drachosaurus/hoerbaer/Hardware/Messungen/Verschiedene_Spannungen_Codec.md

# Codec Temperatur und Strom bei verschiedenen Spannungen

## VAudio = 12V

Bei 384kHz
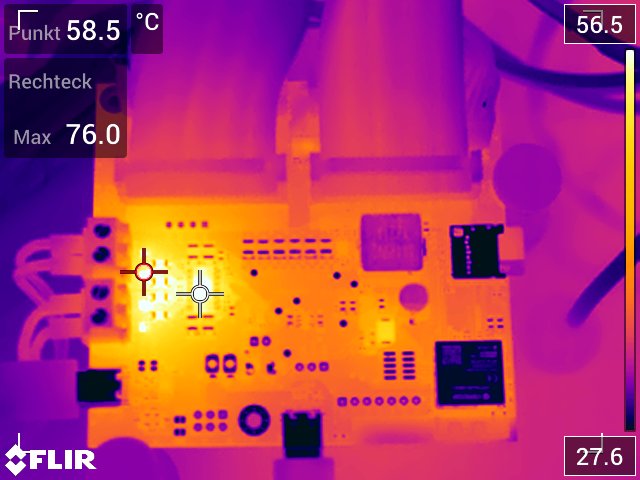
[picture p1: Hardware/Messungen/91_384kHz_12V.jpg]


Bei 768kHz
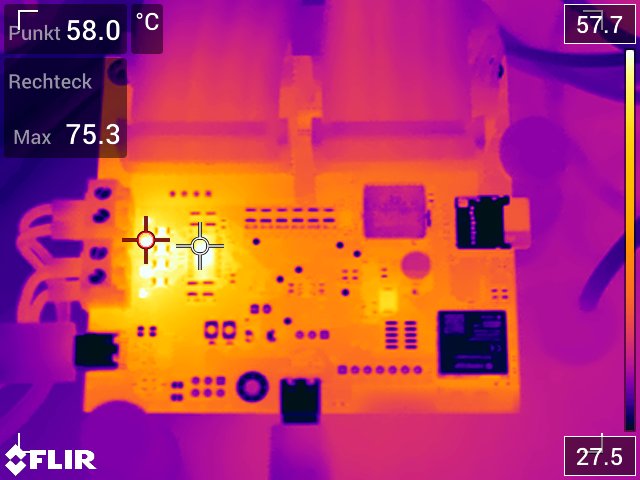
[picture p2: Hardware/Messungen/92_768kHz_12V.jpg]


### Stromaufnahme Codec
183 mA @12V = 2.2W

## VAudio = 9V

Leise
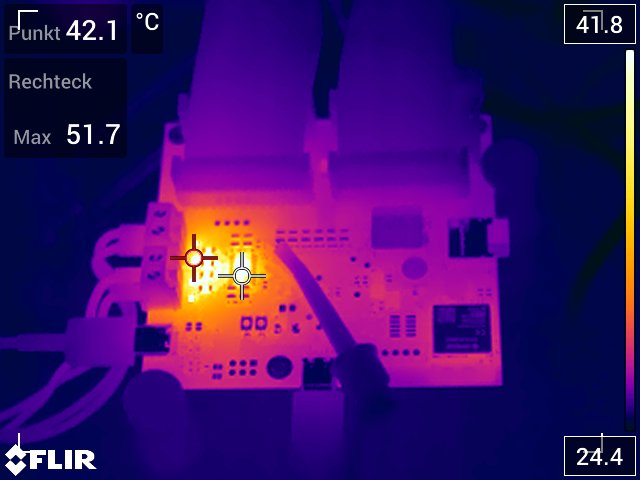
[picture p3: Hardware/Messungen/95_9V_leise.jpg]


Laut
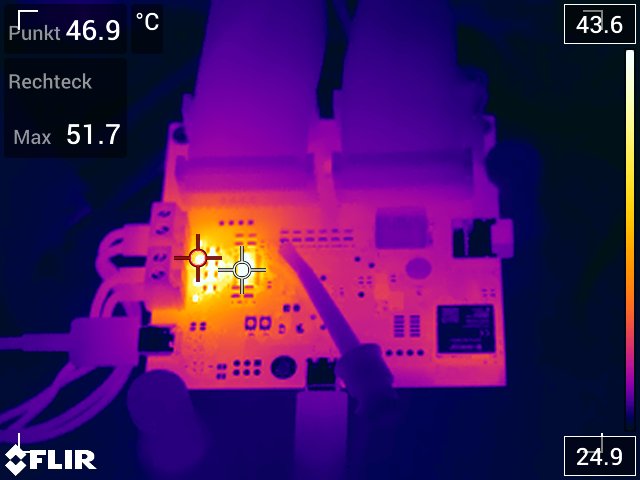
[picture p4: Hardware/Messungen/95_9V_laut.jpg]


### Stromaufnahme Codec

Leise  
PSU: 147mA @9V

Oszibild (Peaks: 132mA - 276mA):
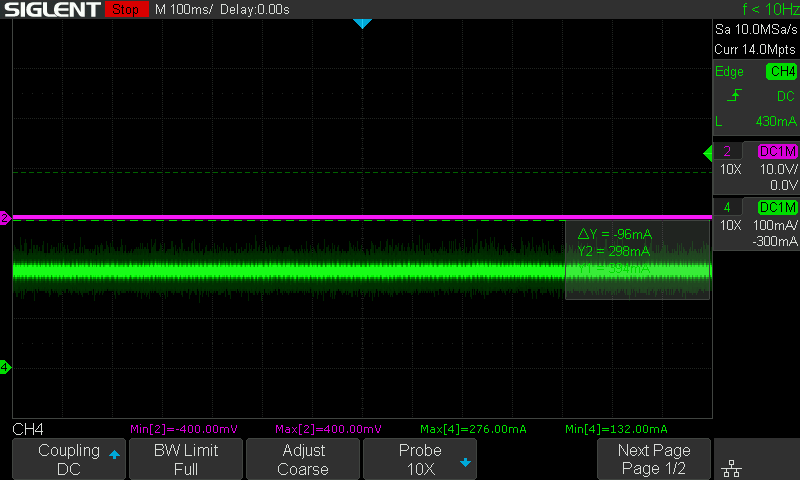
[picture p5: Hardware/Messungen/95_Stromverbrauch_9V_leise.png]


Laut  
PSU: 200mA @9V

Oszibild (Peaks: 96mA - 512mA):
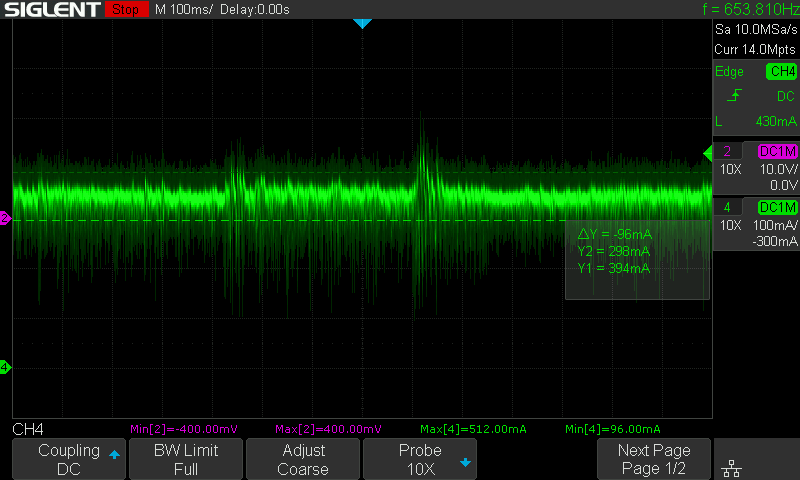
[picture p6: Hardware/Messungen/95_Stromverbrauch_9V_laut.png]


## VAudio = 8V

Leise   
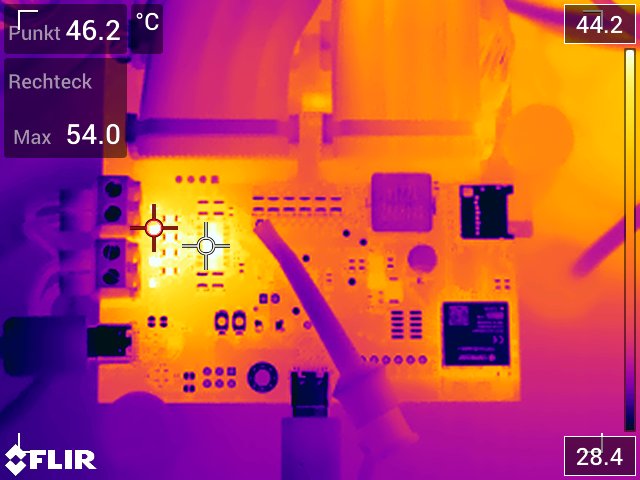
[picture p7: Hardware/Messungen/93_786kHz_8V_leise.jpg]


Laut  
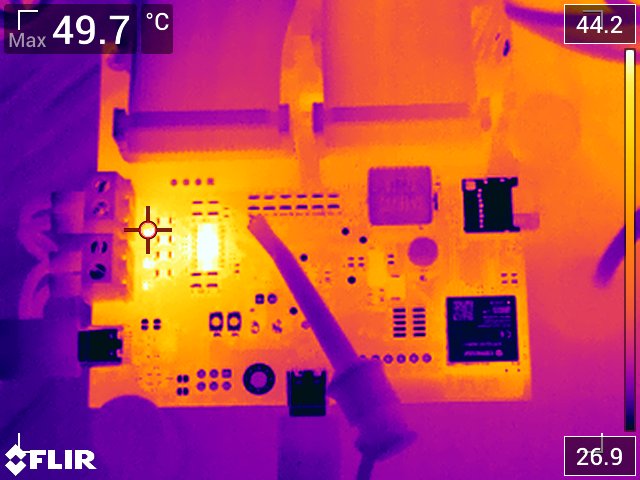
[picture p8: Hardware/Messungen/94_786kHz_8V_laut.jpg]


### Stromaufnahme Codec
134 mA @8V = 1.07W

## VAudio = 7V

Leise
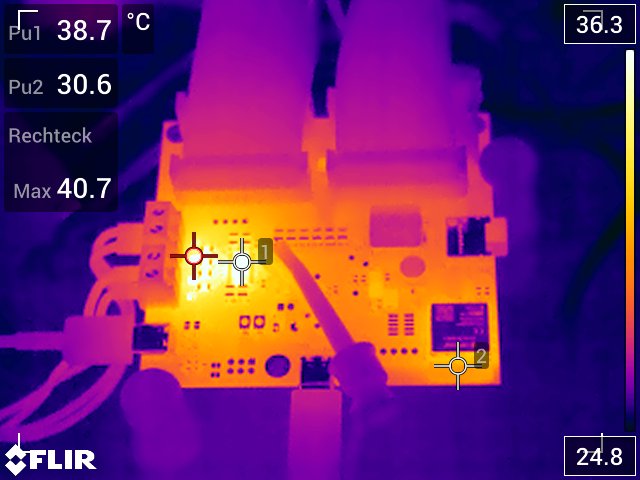
[picture p9: Hardware/Messungen/96_7V_leise.jpg]


### Stromaufnahme Codec
122mA @7V

## VAudio = 5V

Leise
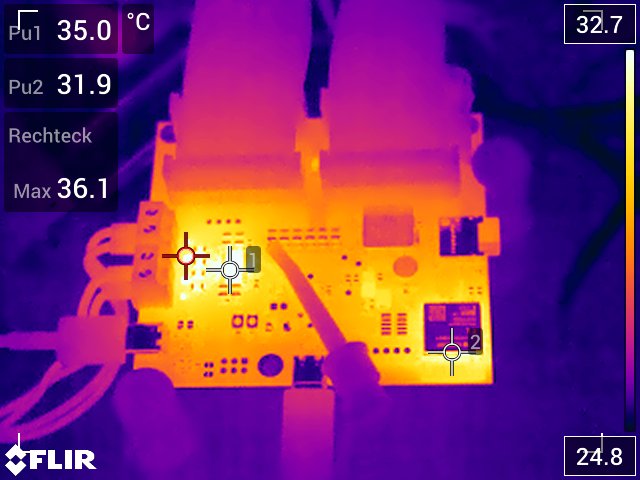
[picture p10: Hardware/Messungen/97_5V_leise.jpg]


### Stromaufnahme Codec
97mA @5V

## HBI

Alle 18 lampen an
177mA @9V
