drachosaurus/hoerbaer/Hardware/Messungen/Strom_HWRev1.md

# Strommessungen - HW Rev 1

## Einschaltstrom ohne Akku

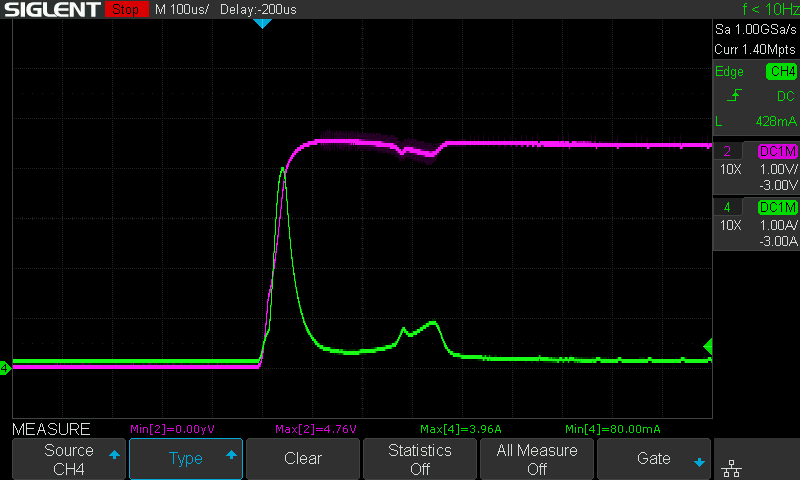
[picture p11: Hardware/Messungen/11_Einschaltstrom_ohneAkku.png]


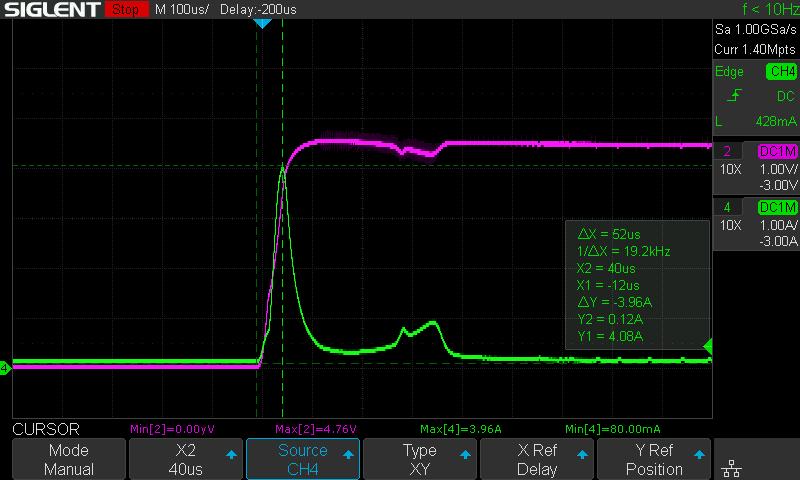
[picture p12: Hardware/Messungen/12_Einschaltstrom_ohneAkku_Cursor.png]


## Einschaltstrom mit Akku

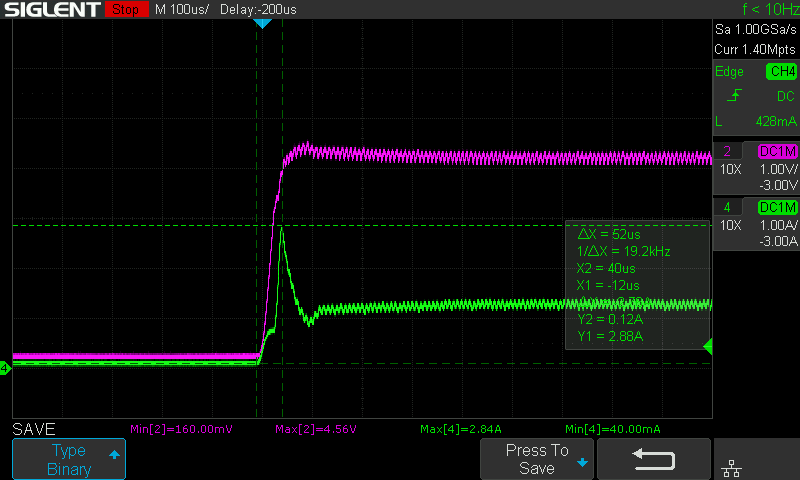
[picture p13: Hardware/Messungen/22_Einschaltstrom_mitAkku_Cursor.png]


## Verbrauch

### Sleep ohne laden
22mA @5V

Gleiche Firmware anderes board (mit Linearregler):  
4mA @5V

### Sleep mit laden
417mA @5V

### Aktiv leise ohne laden

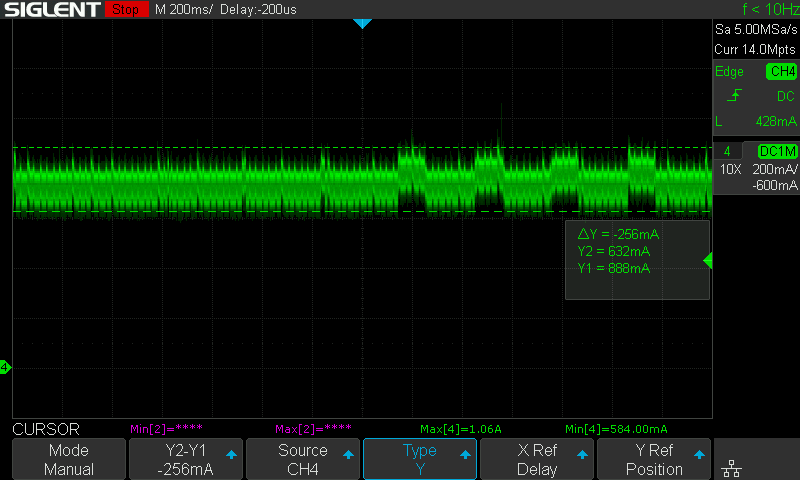
[picture p14: Hardware/Messungen/31_Stromverbrauch_Musik_leise.png]


### Aktive laut ohne laden

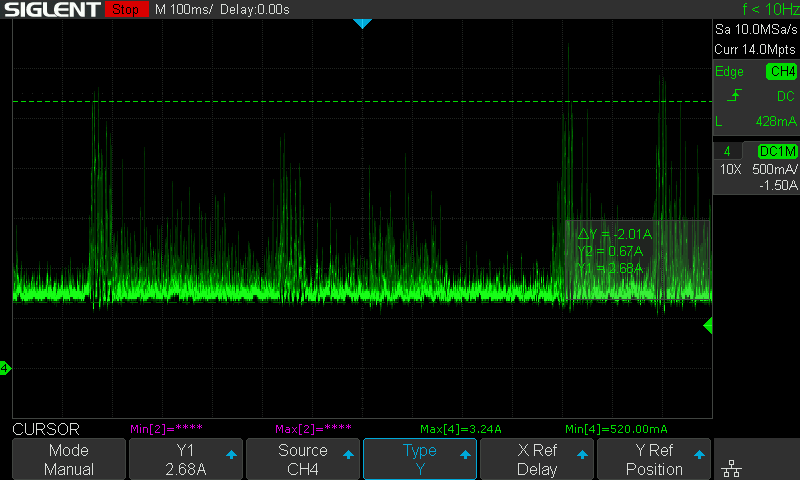
[picture p15: Hardware/Messungen/32_Stromverbrauch_Musik_laut_peaks.png]


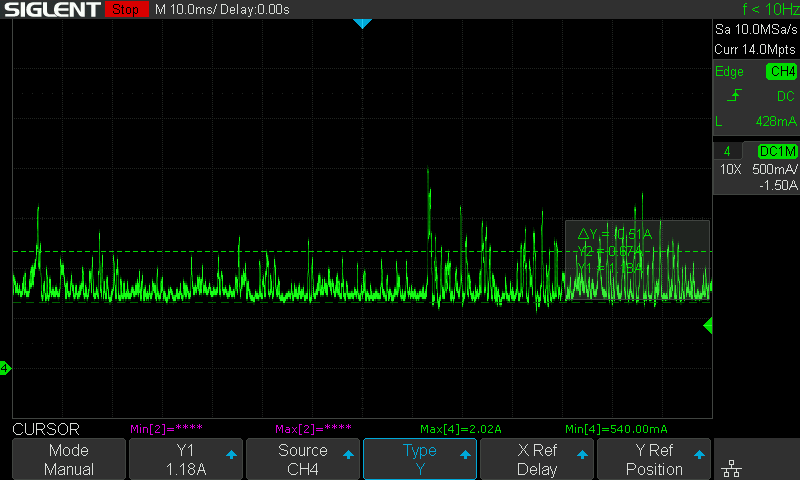
[picture p16: Hardware/Messungen/32_Stromverbrauch_Musik_laut_realistisch.png]


## Startsequenz einzeln

### Start - nichts initialisiert

52mA @5V

- i2c noch nicht initialisiert
- power save 3v3V immernoch ein

### Nach ESP wakeup check 

73mA @5V

- i2c Initialisiert und VCC PowerSave off

### Nach SD Karte

75mA @5V

- SD initialisiert und user config geladen

### Nach HBI ein

80mA @5V

- HBI initialisiert

### Nach Audio ein und 12V ein

562mA @5V

- Audio initialisiert 
- NPDN vom 12V booster on

### Nach WiFi ein

Kurzzeitige Peaks zu 600mA @5V

- Wifi verbunden
