drachosaurus/hoerbaer/Hardware/Hoerbaer/TPS61288 Calculation tool.xlsx

 | TPS61288 18V, 15A Boost Converter Design Tool
 |  |  | User Input |  |  | ABOUT |  |  | Terms of Use
Input Voltage Parameters
Input Minimum Voltage | 2.8 | V
Input Norminal Voltage | 3.5 | V |  |  |  |  | 5.60 | uH
Input Maximum Voltage | 4.2 | V |  | 3.5 | V
Output Parameters
Output Voltage | 9 | V |  |  |  |  |  |  |  |  | 9 | V
Maximum Output Current | 0.9 | A |  |  |  |  |  |  |  |  | 0.9 | A
Efficiency | 90 | %
 |  |  |  |  |  |  |  |  |  |  |  | 66 | uF
Setting Output Voltage
Resistor Divider R2 | 31 | kΩ |  |  |  |  |  |  | 434 | kΩ
Resistor Divider R1 | 434 | kΩ |  |  |  |  |  |  |  | 0.3669024626 | pF
Frequency and Duty at Normal Inout Voltage |  |  | 0.6
Switching Frequency | 0.5 | MHz | 2.6 |  |  |  |  |  | 31 | kΩ
Duty Cycle | 0.65 |  | 1
Inductor Selection
Inductor DC Current | 2.57 | A
Inductor Peak-to-Peak Current Ratio | 32 | %
Calculated Inductance Value | 5.53 | uH
Selected Inductance Value L1 | 5.60 | uH
Inductor Peak-to-Peak Current | 0.81 | A
Inductor Peak Current | 2.98 | A
Inductor Valley Current | 2.17 | A
Output Capacitor Selection
Output Ripple | 30 | mV
Calculated Effective Output Capacitance | 43.20 | uF
Selected Effective Output Capacitance C2 | 66 | uF
Output Capacitor ESR | 1 | mΩ
Real Output Ripple | 22.61 | mV
Loop Stability and Feedforward Capacitor
Rc COMP | 47.0 | kΩ
Cc COMP | 4.7 | nF
Cp COMP | 27 | pF |  |  | time | IL
Zero Frequency Inducing by Feedforward Capacitor | 1000 | kHz |  |  | 0 | 2.17
Feedforward Capacitance C3 | 0.3669024626 | pF |  |  | 1.3 | 2.98
Cross-over Frequency | 7.8 | kHz |  |  | 2 | 2.17
Phase Margin | 73 | ⁰ |  |  | 3.3 | 2.98
Gain Margin | 16 | dB |  |  | 4 | 2.17
