drachosaurus/hoerbaer/Hardware/Hoerbaer/TAS5805M_4Ohm.png

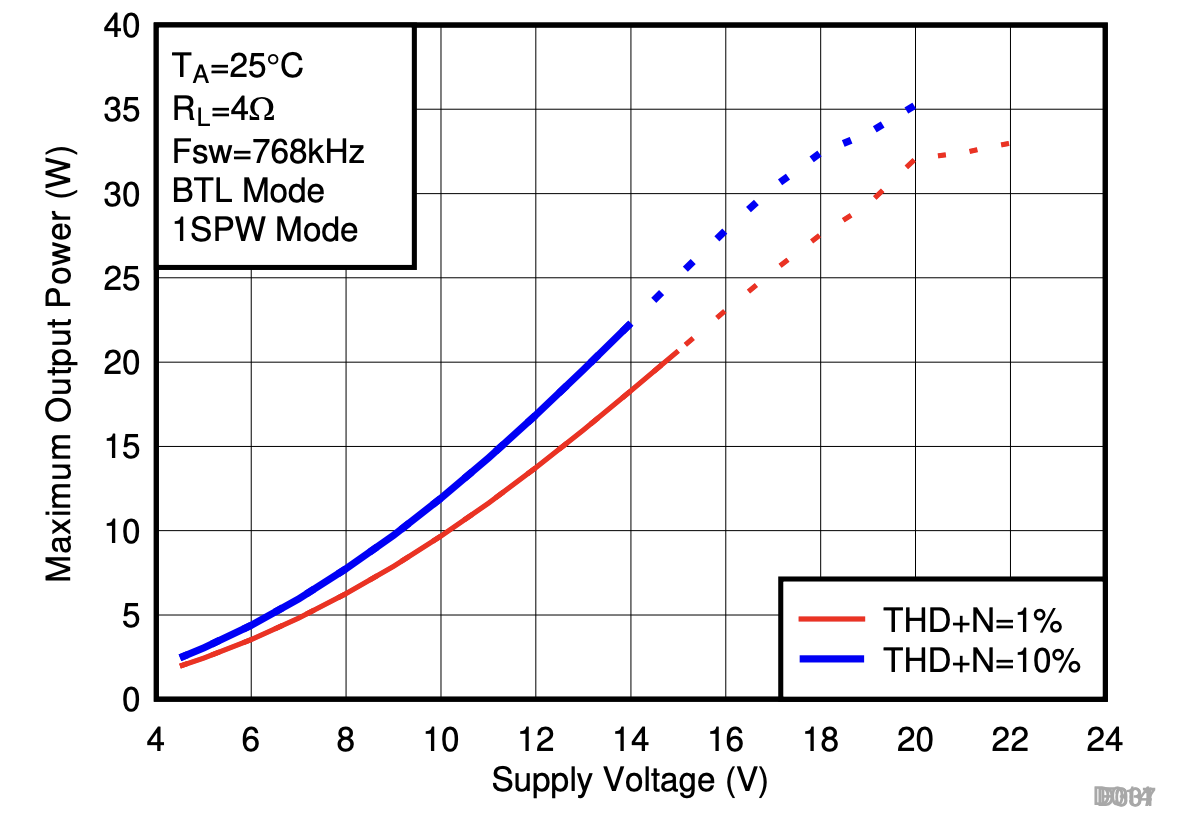
Hardware/Hoerbaer/TAS5805M_4Ohm.png
