drachosaurus/hoerbaer/Hardware/Hoerbaer/TAS5805M_8Ohm.png

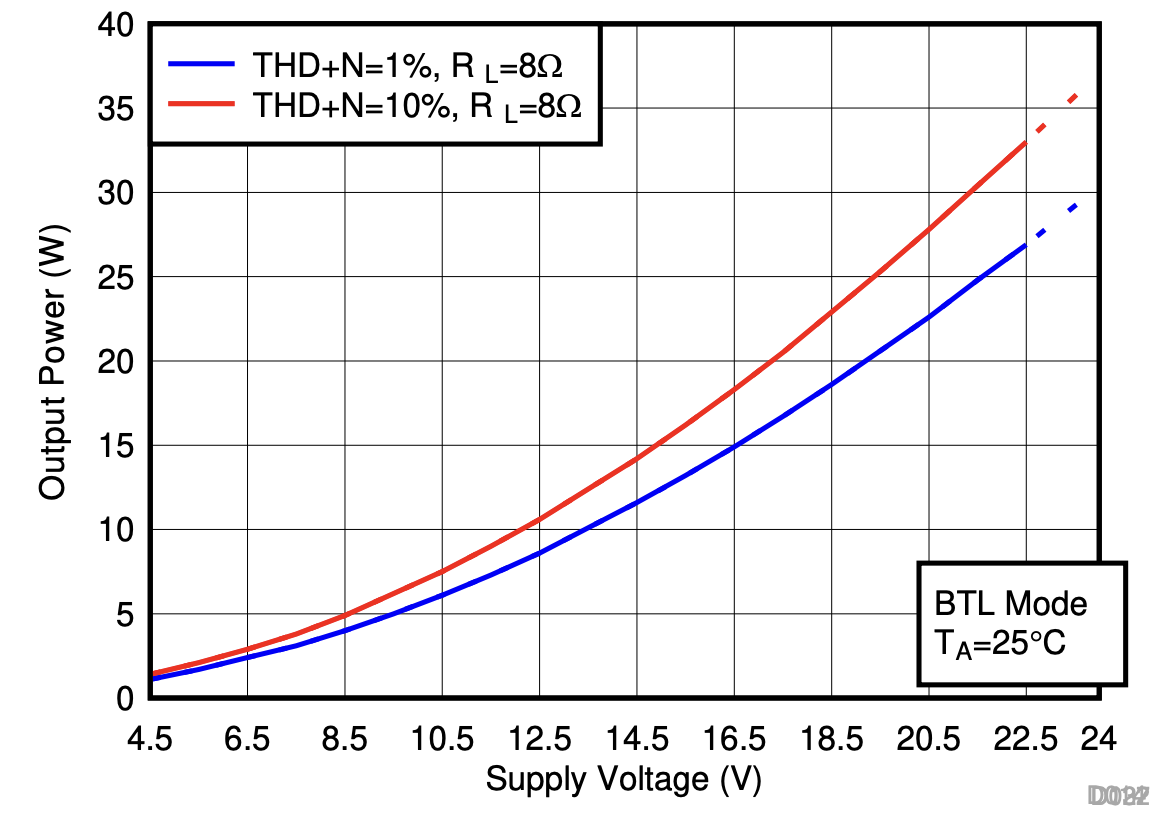
Hardware/Hoerbaer/TAS5805M_8Ohm.png
