drachosaurus/hoerbaer/Hardware/Hoerbaer/TLC59108_rext_led_current.png

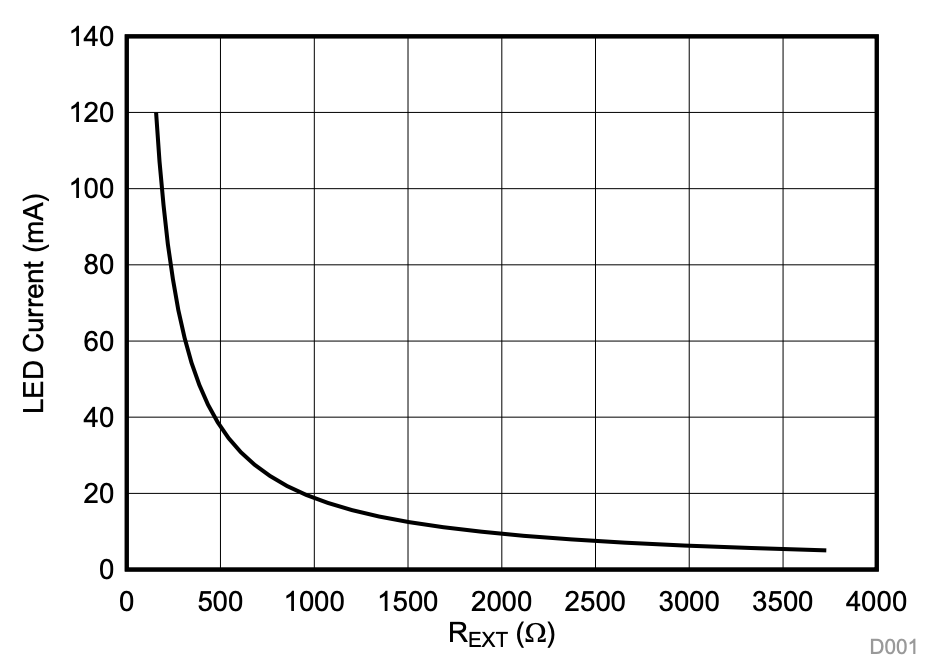
Hardware/Hoerbaer/TLC59108_rext_led_current.png
