drachosaurus/hoerbaer/Hardware/Ref/adafruit_products_MS3_sch.png

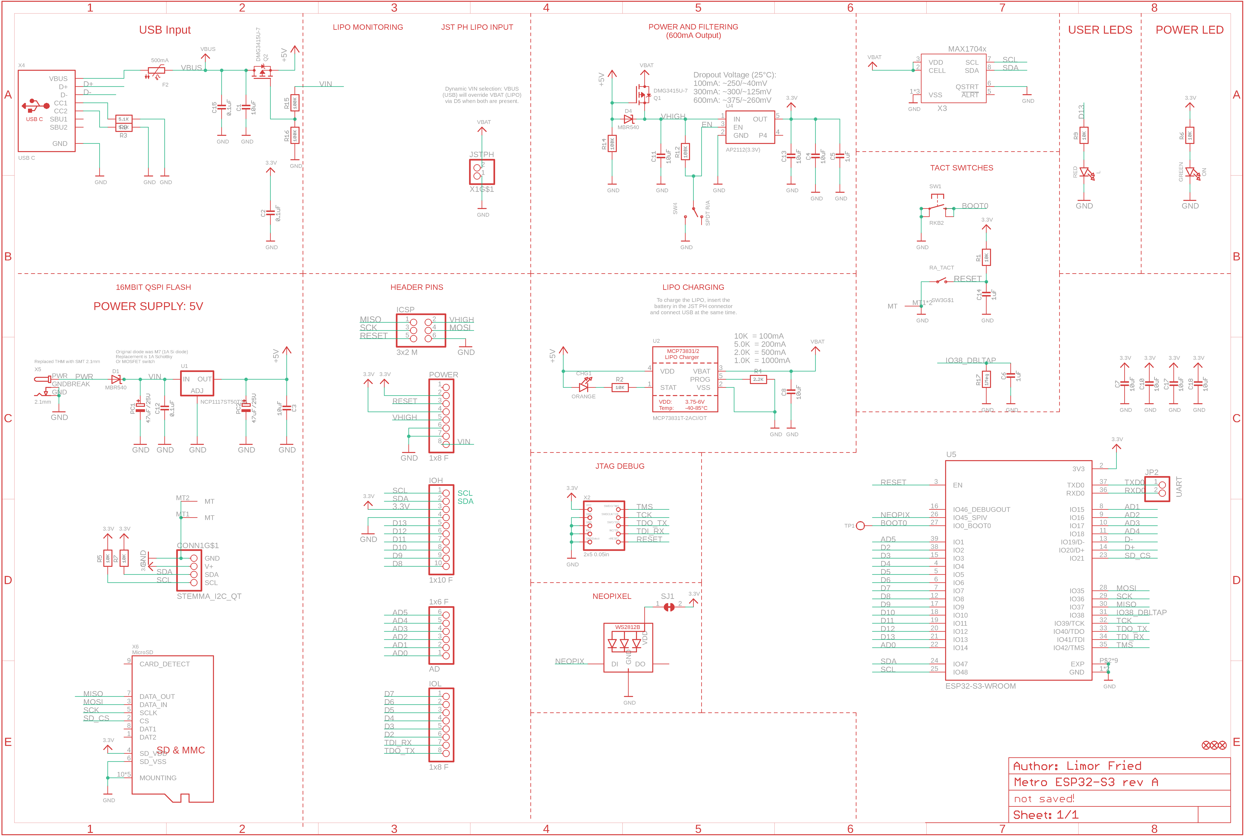
Hardware/Ref/adafruit_products_MS3_sch.png
