drachosaurus/hoerbaer/Hardware/Case/Button Führung.3mf

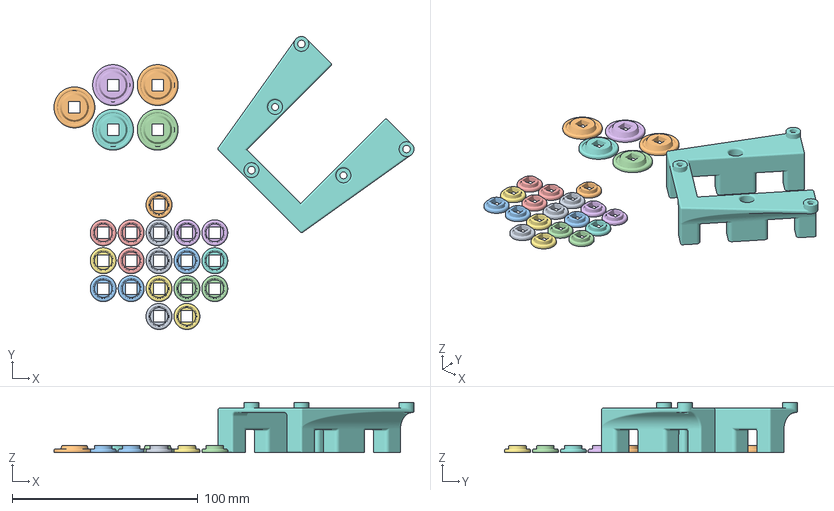
[picture p21: CAD file, 2025-04-26]
Hardware/Case/Button Führung.3mf
193.6 x 157.6 x 26.9 mm
Button Führung klein.stl x 18
Button Führung gross.stl x 5
Halterung PCB.stl
