drachosaurus/hoerbaer/Hardware/Tatze/Pfote.dxf

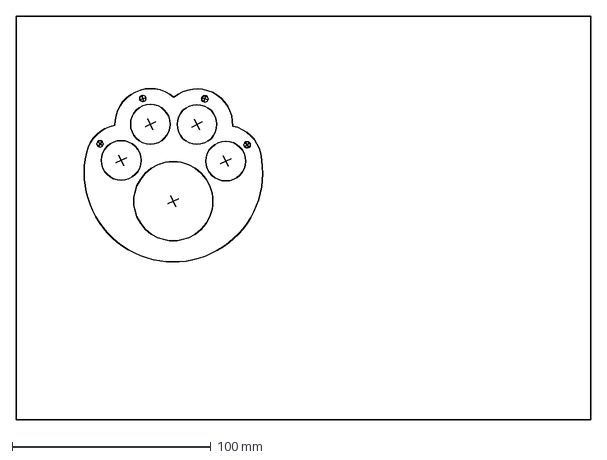
[picture p22: CAD file, 2025-03-30]
Hardware/Tatze/Pfote.dxf
289.0 x 203.0 mm
