drachosaurus/hoerbaer/Hardware/Case/Abdeckung Anschlüsse.3mf

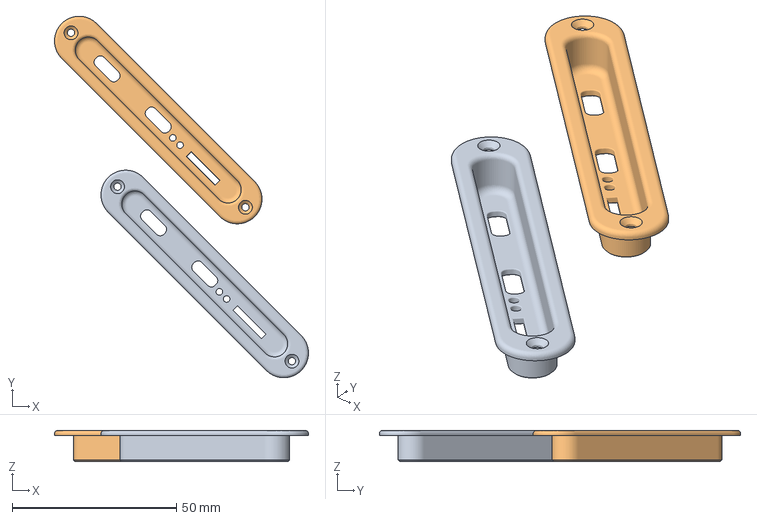
[picture p23: CAD file, 2025-04-20]
Hardware/Case/Abdeckung Anschlüsse.3mf
77.2 x 109.9 x 9.50 mm
Abdeckung Anschlüsse.stl x 2
