drachosaurus/hoerbaer/Hardware/Case/Halterung PCB.3mf

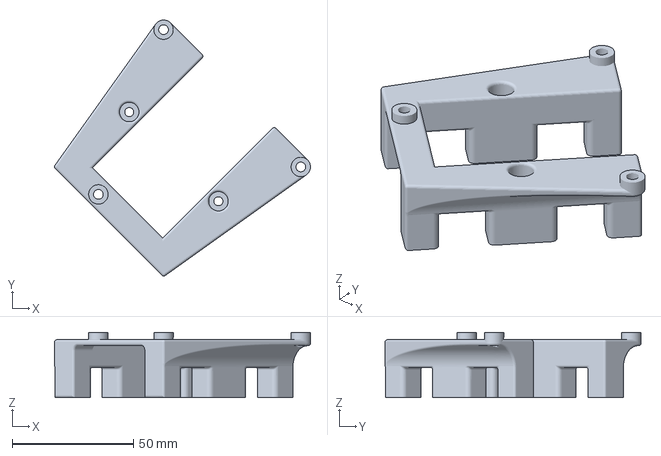
[picture p24: CAD file, 2025-04-20]
Hardware/Case/Halterung PCB.3mf
105.5 x 105.5 x 26.9 mm
