drachosaurus/hoerbaer/Hardware/Case/Proto Case Top.stl

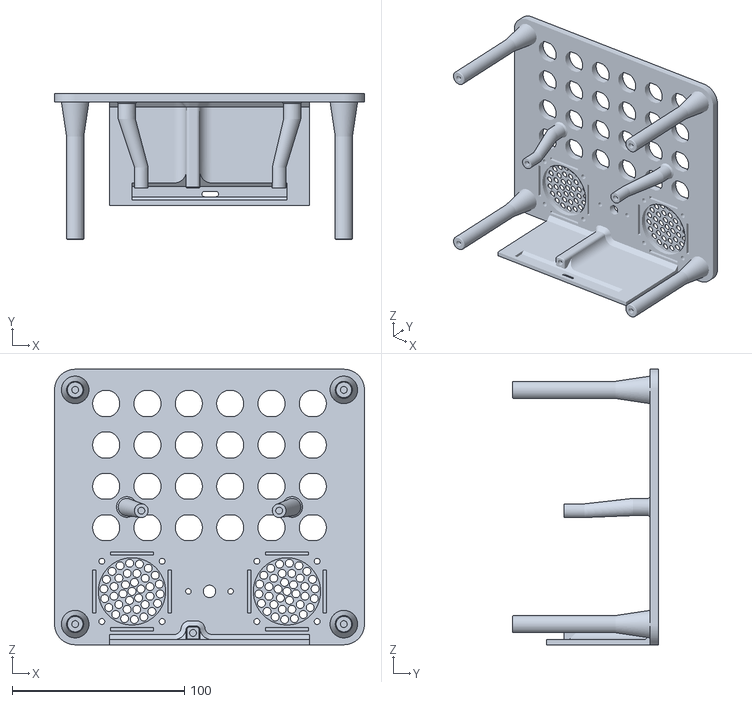
[picture p25: CAD file, 2023-12-07]
Hardware/Case/Proto Case Top.stl
180.0 x 85.0 x 160.0
