drachosaurus/hoerbaer/Hardware/Case/Proto Case Encoder Holder.stl

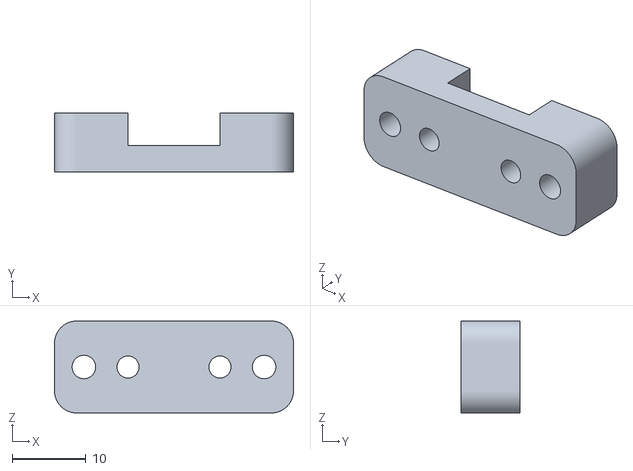
[picture p26: CAD file, 2023-12-07]
Hardware/Case/Proto Case Encoder Holder.stl
32.5 x 8.00 x 12.5
