drachosaurus/hoerbaer/(list of files, cad)

Other CAD files:
Hardware/Case/Button Führung gross.stl
Hardware/Case/Button Führung klein.stl
Hardware/Case/Abdeckung Anschlüsse.stl
Hardware/Case/Halterung PCB.stl
