drachosaurus/hoerbaer/Hardware/Tatze/HoerbaerV2Tatze.kicad_pcb

## KiCad design Hardware/Tatze/HoerbaerV2Tatze.kicad_pcb (2025-03-30)

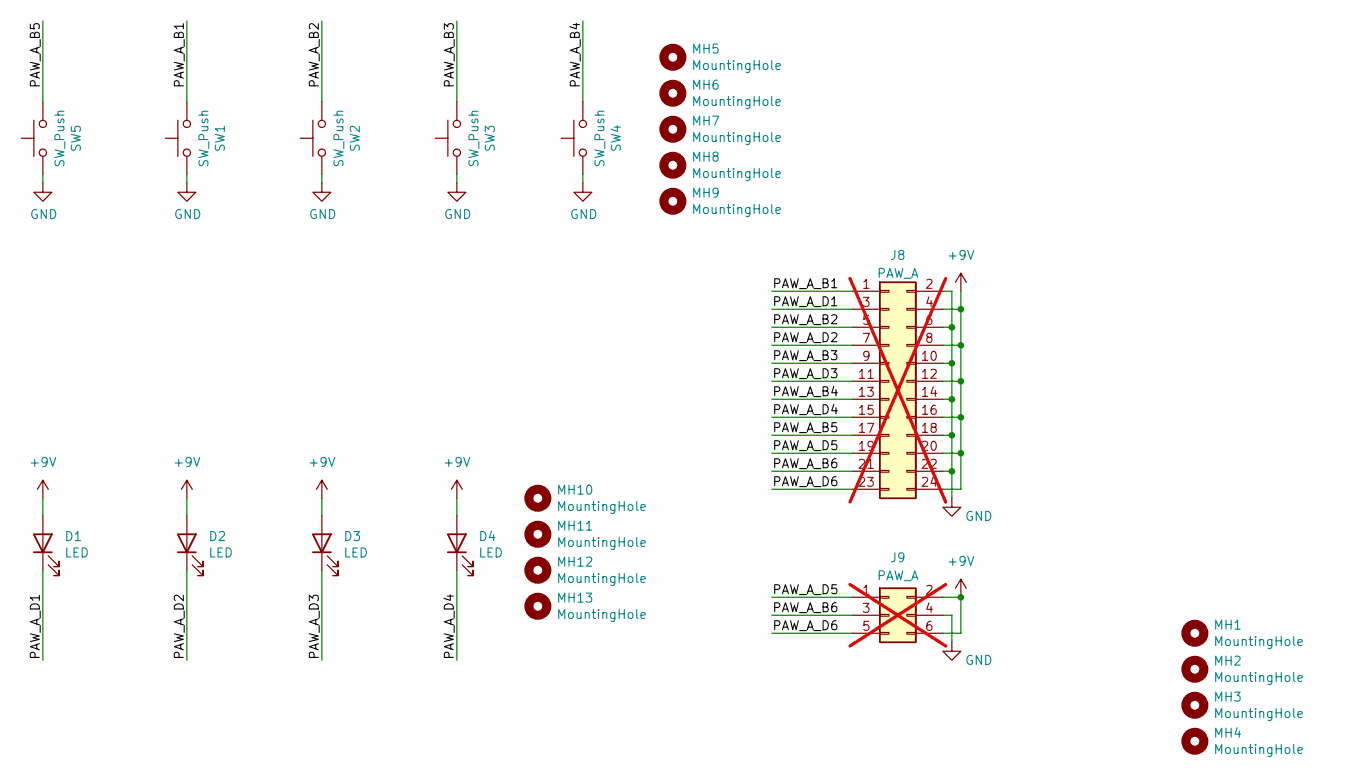
[picture p27: schematic HoerbaerV2Tatze.kicad_sch]

Parts:
D1, D2, D3, D4: LED; LED_D3.0mm
J8: PAW_A; PinHeader_2x12_P2.54mm_Vertical; JLCPCB Rotation Offset 90; not fitted
J9: PAW_A; PinHeader_2x03_P2.54mm_Vertical; JLCPCB Rotation Offset 90; not fitted
MH1, MH2, MH3, MH4: MountingHole; MountingHole_3.2mm_M3
MH5, MH6, MH7, MH8, MH9, MH10, MH11, MH12, MH13: MountingHole; MountingHole_2.1mm
SW1, SW2, SW3, SW4, SW5: SW_Push; SW_PUSH_6mm

Connections:
+9V: D1.2 (A), D2.2 (A), D3.2 (A), D4.2 (A), J8.4, J8.8, J8.12, J8.16, J8.20, J8.24, J9.2, J9.6
/PAW_A_B1: J8.1, SW1.2
/PAW_A_B2: J8.5, SW2.2
/PAW_A_B3: J8.9, SW3.2
/PAW_A_B4: J8.13, SW4.2
/PAW_A_B5: J8.17, SW5.2
/PAW_A_B6: J8.21, J9.3
/PAW_A_D1: D1.1 (K), J8.3
/PAW_A_D2: D2.1 (K), J8.7
/PAW_A_D3: D3.1 (K), J8.11
/PAW_A_D4: D4.1 (K), J8.15
/PAW_A_D5: J8.19, J9.1
/PAW_A_D6: J8.23, J9.5
GND: J8.2, J8.6, J8.10, J8.14, J8.18, J8.22, J9.4, SW1.1, SW2.1, SW3.1, SW4.1, SW5.1

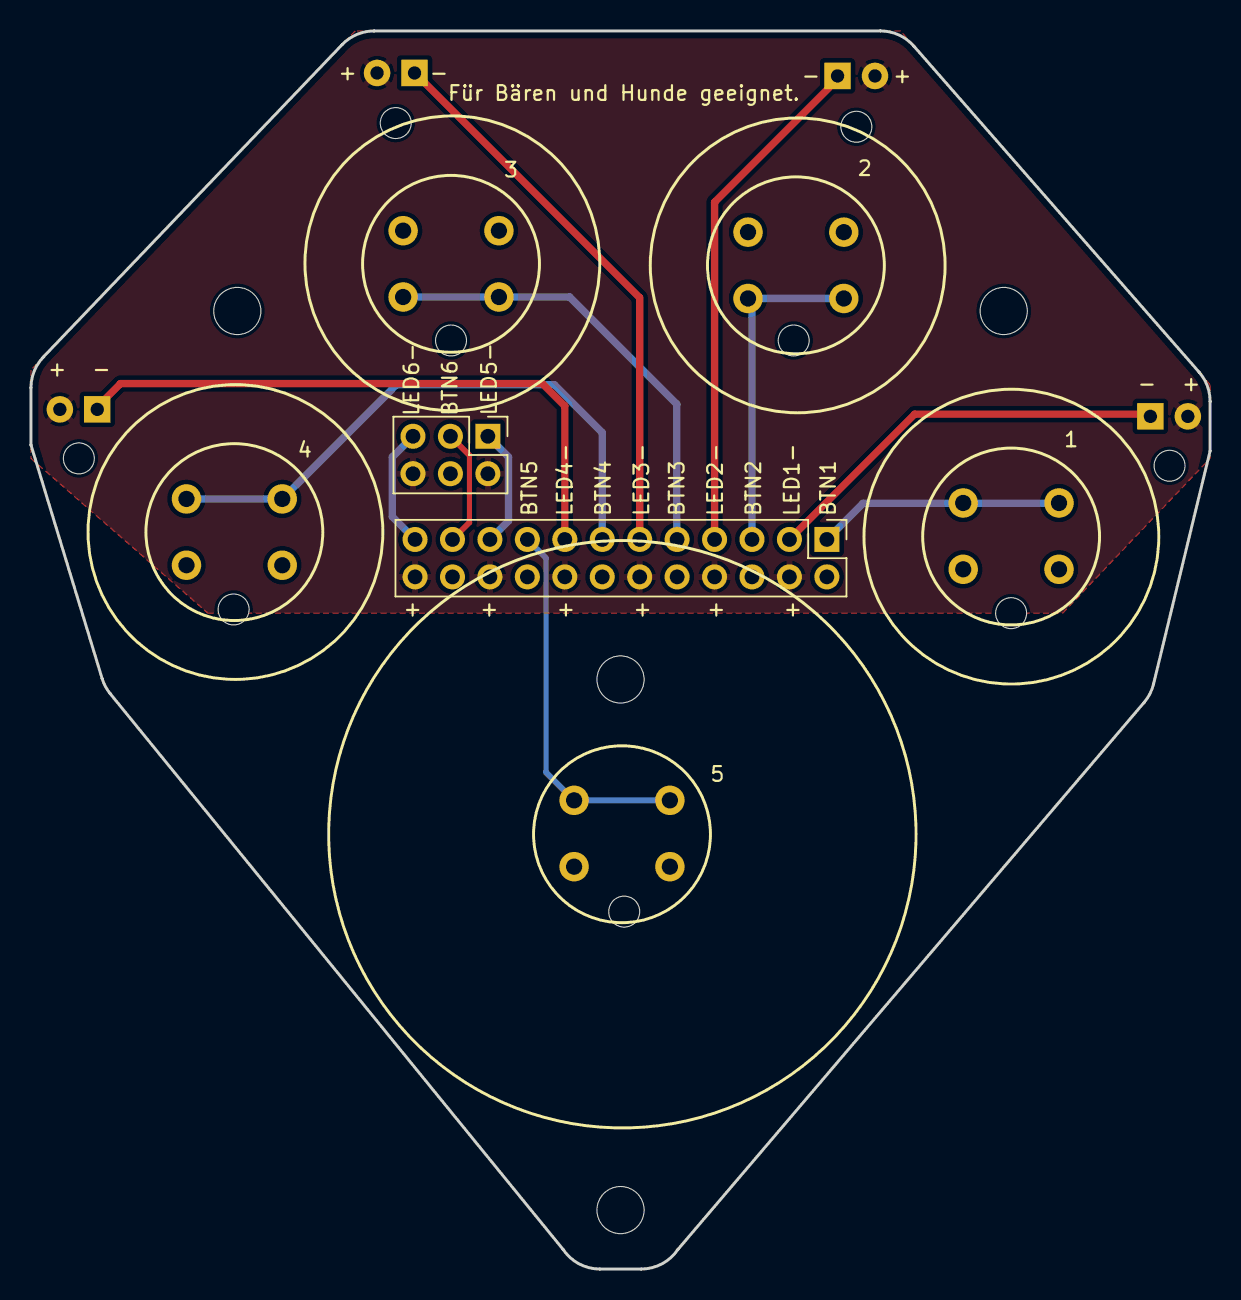
[picture p28: board HoerbaerV2Tatze.kicad_pcb from above]

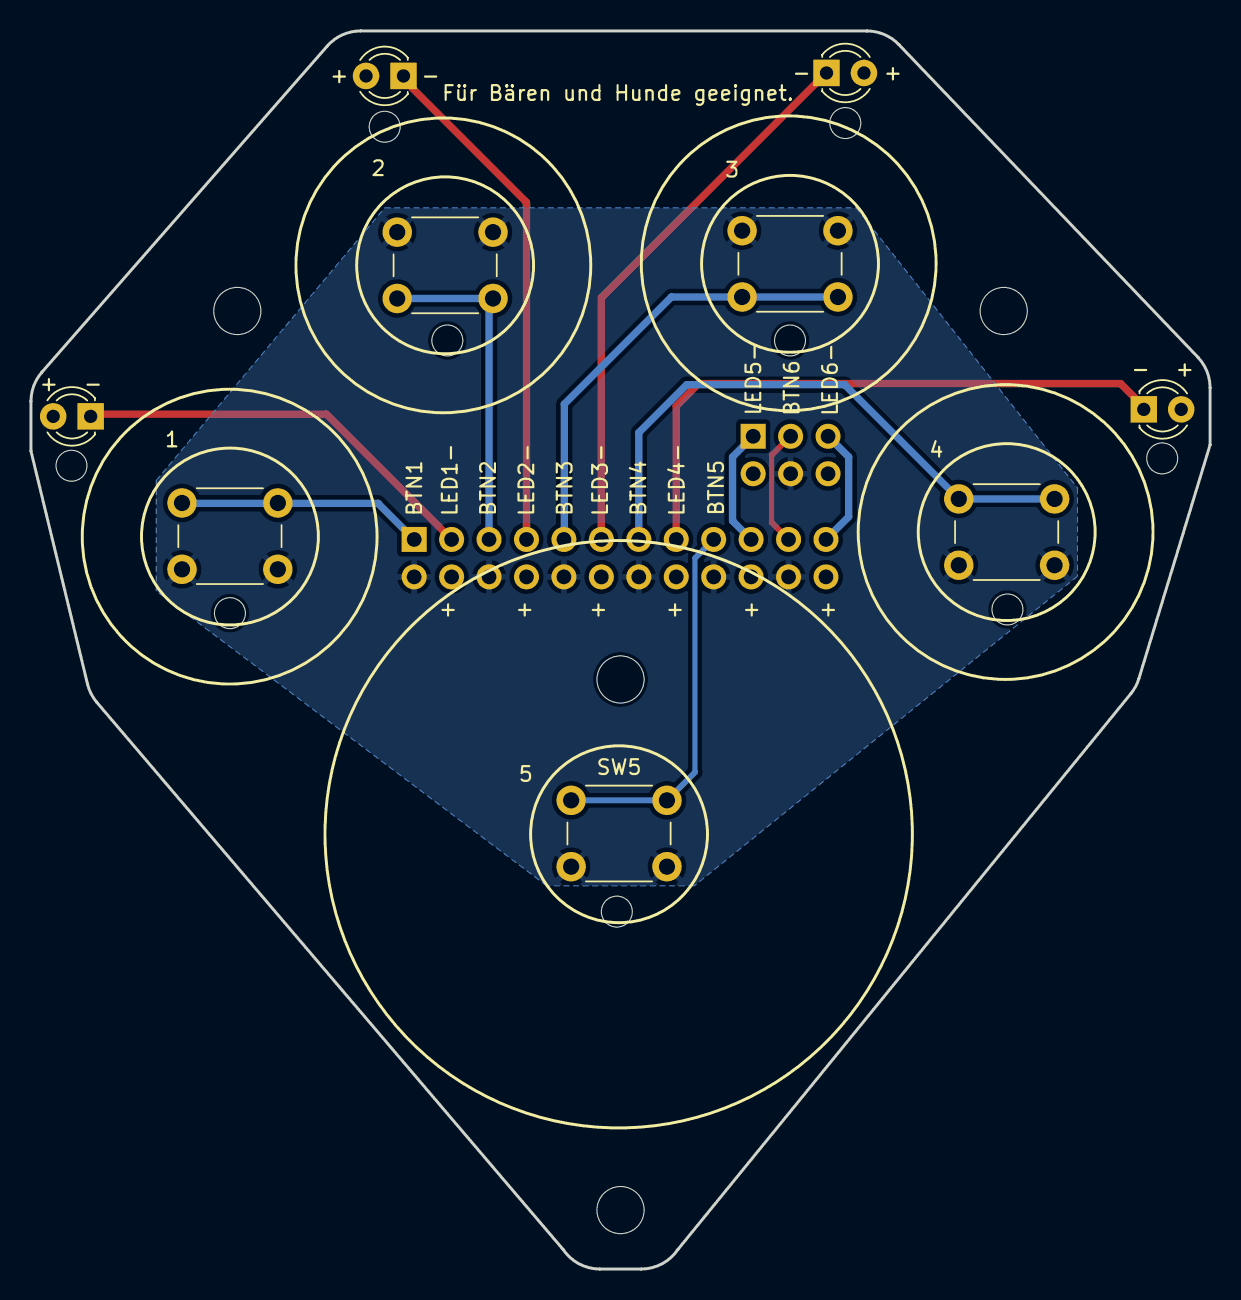
[picture p29: board HoerbaerV2Tatze.kicad_pcb from below]

Board: 2 copper layers, 80.0 x 84.0 mm, 24 parts (9 on the bottom side), 14 nets.
