drachosaurus/hoerbaer/Hardware/Hoerbaer/Hoerbaer.kicad_pcb

## KiCad design Hardware/Hoerbaer/Hoerbaer.kicad_pcb (2025-03-16)

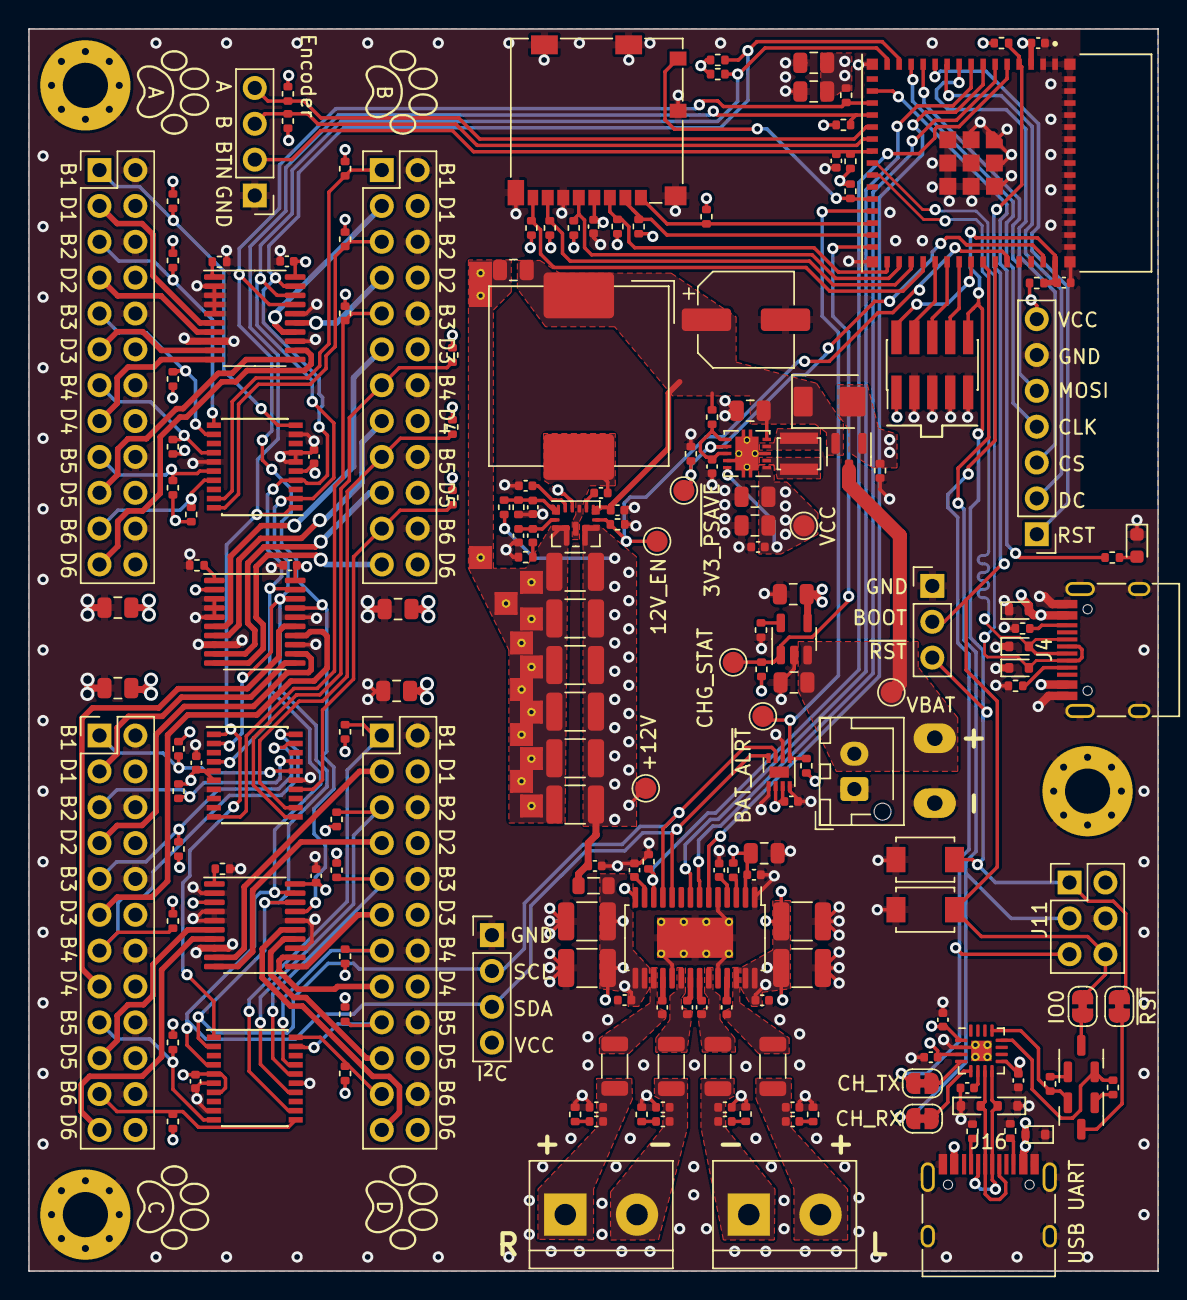
[picture p30: board Hoerbaer.kicad_pcb from above]

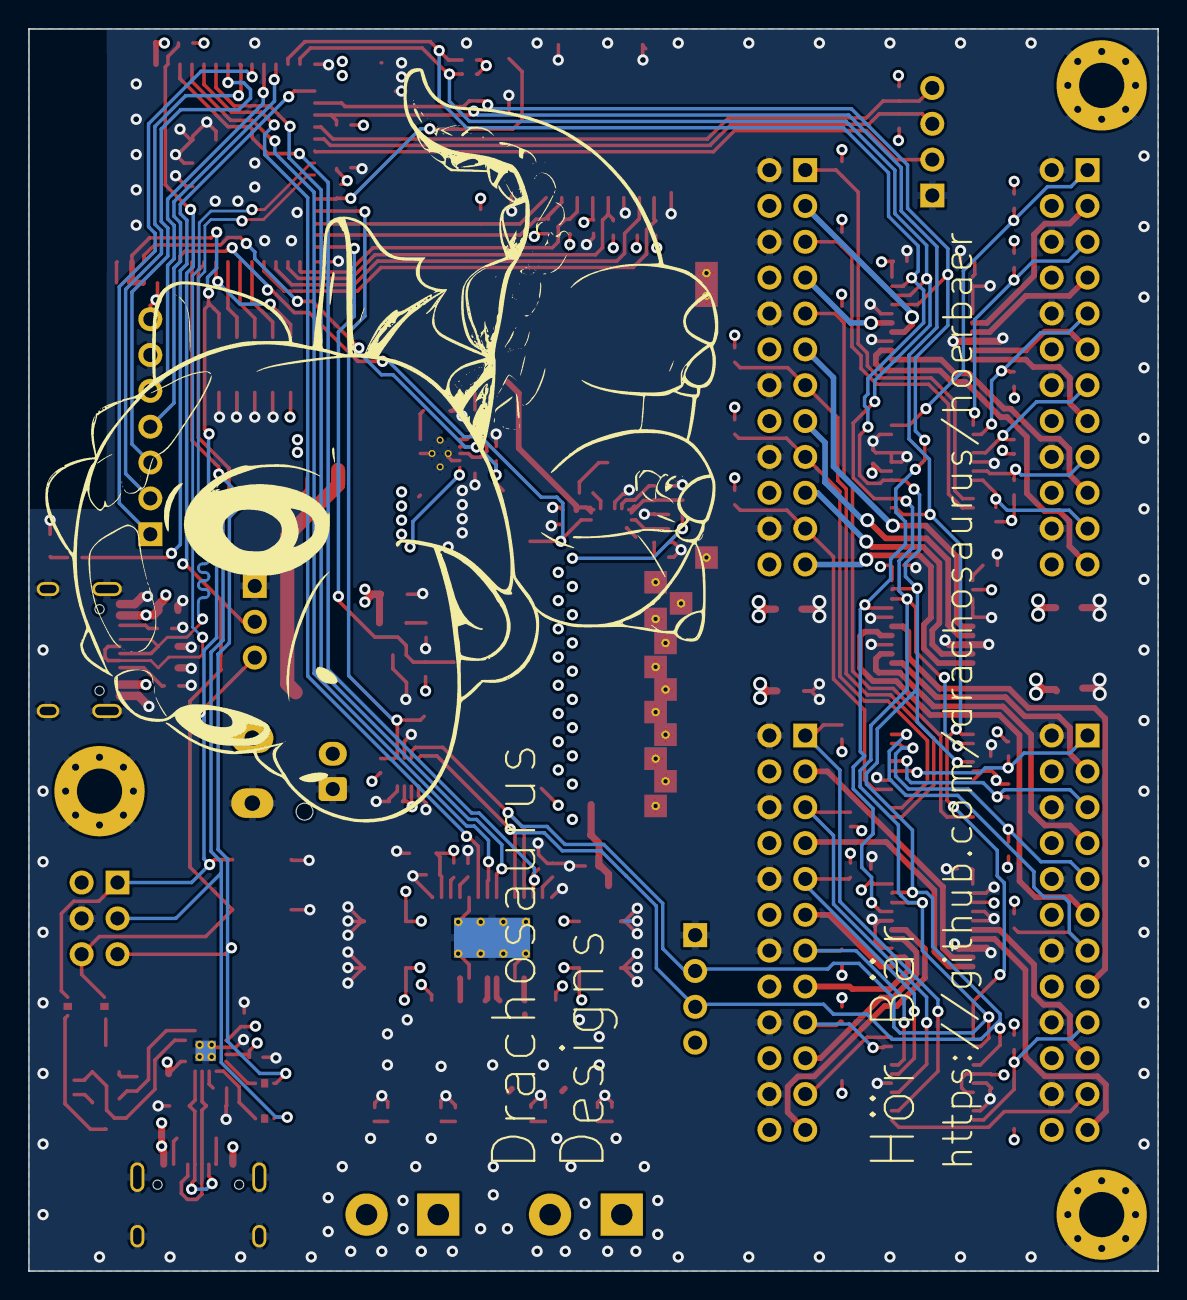
[picture p31: board Hoerbaer.kicad_pcb from below]

Board: 4 copper layers, 80.0 x 88.0 mm, 209 parts (14 on the bottom side), 143 nets.

Parts:
C1, C4, C5, C15, C20, C34, C35: 1µF, 10V; C_0402_1005Metric
C2, C3, C13, C14, C16, C22, C23, C24, C26, C65: 10µF; C_0805_2012Metric
C6, C7, C8, C9, C10, C11, C12, C19, C21, C25, C36, C43, C50, C58, C63, C64: 100nF; C_0402_1005Metric
C17, C18, C55: 4.7µF, 10V; C_0805_2012Metric
C27, C28, C29, C30, C31, C32, C37, C38, C44, C45: 22µF, low ESR; C_1210_3225Metric
C33, C46, C47, C48, C49, C51, C52, C53, C54: 2.2nF; C_0402_1005Metric
C39, C40, C41, C42: 220nF; C_0402_1005Metric
C56, C57: 1uF; C_0402_1005Metric
C59, C61: 27pF; C_0402_1005Metric
C60: 4.7nF; C_0402_1005Metric
C62: 47µF; CP_Elec_6.3x5.9
D1, D2, D5, D6, D7, D8: LESD5D5.0CT1G; D_SOD-523
D3: S54BF
D4: GREEN; LED_0603_1608Metric
FB1: 100Ω@100MHz, 3A; L_0805_2012Metric
FB2, FB3, FB4, FB5: 300Ω@100MHz, 3A; L_1206_3216Metric
H1, H2, H3: MountingHole_Pad; MountingHole_3.2mm_M3_Pad_Via
J1: I2C; PinHeader_1x04_P2.54mm_Vertical
J2: DISPLAY; PinHeader_1x07_P2.54mm_Vertical
J3: uSD; microSD_HC_Molex_104031-0811
J4: USB1; USB_C_Receptacle_HRO_TYPE-C-31-M-12
J5: ENCODER; PinHeader_1x04_P2.54mm_Vertical
J6: PAW_A; PinHeader_2x12_P2.54mm_Vertical
J7: PAW_B; PinHeader_2x12_P2.54mm_Vertical
J8: PAW_C; PinHeader_2x12_P2.54mm_Vertical
J9: PAW_D; PinHeader_2x12_P2.54mm_Vertical
J10: Battery 1S Li-Ion; SolderWire-0.5sqmm_1x02_P4.6mm_D0.9mm_OD2.1mm
J11: UART; PinHeader_2x03_P2.54mm_Vertical
J12: Battery 1S Li-Ion; JST_XH_B2B-XH-AM_1x02_P2.50mm_Vertical
J13: JTAG; PinHeader_2x05_P1.27mm_Vertical_SMD
J14: Speaker_L; TerminalBlock_bornier-2_P5.08mm
J15: Speaker_R; TerminalBlock_bornier-2_P5.08mm
J16: USB2_UART; USB_C_Receptacle_HRO_TYPE-C-31-M-12
J17: RST_BOOT; PinHeader_1x03_P2.54mm_Vertical
JP1: CH_TX; SolderJumper-2_P1.3mm_Bridged_RoundedPad1.0x1.5mm
JP2: CH_RX; SolderJumper-2_P1.3mm_Bridged_RoundedPad1.0x1.5mm
JP3: ~{RST}; SolderJumper-2_P1.3mm_Bridged_RoundedPad1.0x1.5mm
JP4: IO0; SolderJumper-2_P1.3mm_Bridged_RoundedPad1.0x1.5mm
L1: 2.2µH; L_Murata_LQH3NPN
L2: 4.7uH, 14A; L_TDK_SPM12565
NT1, NT2, NT3, NT4, NT5, NT6, NT7, NT8, NT9, NT10, NT11, NT12, NT13, NT14: GNDs; NetTie-2_Via
Q1: DMG3415UQ-7; SOT-23
Q5, Q6: S8050; SOT-23
R1, R2, R3, R4, R7, R8, R9, R10, R11, R12, R13, R14, R15, R16, R17, R18, R19, R20, R21, R22, R23, R24, R25, R26, R27, R28, R29, R30, R31, R32, R33, R34, R35, R36, R37, R38, R39, R40, R41, R42, R46, R50, R51, R52, R54, R61, R69, R70: 10kΩ; R_0402_1005Metric
R5, R6, R56, R67, R68: 5.1kΩ; R_0402_1005Metric
R43, R44, R45, R49: 2kΩ; R_0402_1005Metric
R47: 100Ω; R_0402_1005Metric
R48: 100kΩ; R_0402_1005Metric
R53: 191kΩ; R_0402_1005Metric
R55: 47kΩ; R_0402_1005Metric
R62: 4.7kΩ; R_0402_1005Metric
R63, R64, R65, R66: 68Ω; R_0402_1005Metric
SW1: RESET; SW_ TS-1088-AR02016
SW2: PROG; SW_ TS-1088-AR02016
TP4: VCC; TestPoint_Pad_D1.5mm
TP5: VBAT; TestPoint_Pad_D1.5mm
TP6: 3V3_~{PSAVE}; TestPoint_Pad_D1.5mm
TP7: 12V_EN; TestPoint_Pad_D1.5mm
TP8: CHG_STAT; TestPoint_Pad_D1.5mm
TP9: BAT_~{ALRT}; TestPoint_Pad_D1.5mm
TP10: +12V; TestPoint_Pad_D1.5mm
U1: ESP32 S3 MINI; XCVR_ESP32-S3-MINI-1-N8
U2, U3, U4: PCF8574APWR; SSOP-20_4.4x6.5mm_P0.65mm
U5, U6, U7: TLC59108xPW; TSSOP-20_4.4x6.5mm_P0.65mm
U8: MCP73831T-2ACI/OT (4.2V); SOT-23-5
U9: TPS63001; Texas_DRC0010J_ThermalVias
U10: TAS5805M; HTSSOP-28-1EP_4.4x9.7mm_P0.65mm_EP2.85x5.4mm_ThermalVias
U11: CH343P; QFN-16-1EP_3x3mm_P0.5mm_EP1.45x1.45mm_ThermalVias
U12: MAX17048G; TDFN-8-1EP_MAXIM
U13: TPS61288; Texas_VQFN-HR-20_3x2.5mm_P0.5mm_RQQ0011A

Connections:
+12V: C22.1, C23.1, C24.1, C27.1, C28.1, C29.1, C30.1, C31.1, C32.1, C33.1, C65.1, FB1.1, J6.4, J6.8, J6.12, J6.16, J6.20, J6.24, J7.4, J7.8, J7.12, J7.16, J7.20, J7.24, J8.4, J8.8, J8.12, J8.16, J8.20, J8.24, J9.4, J9.8, J9.12, J9.16, J9.20, J9.24, R53.1, TP10.1, U13.5 (VOUT)
+BATT: C17.1, C19.1, J10.2, J12.2, Q1.3 (D), TP5.1, U8.3 (VBAT), U12.2 (CELL), U12.3 (VDD)
/3V3_~PSAVE: R46.1, TP6.1, U1.44 (IO46), U9.7 (PS/SYNC)
/12V_EN: R52.1, TP7.1, U1.41 (IO45), U13.6 (EN)
/Audio/AMP_OUT_A+: C39.2, FB2.1, U10.26 (OUT_A+)
/Audio/AMP_OUT_A-: C40.2, FB3.1, U10.23 (OUT_A-)
/Audio/AMP_OUT_B+: C41.2, FB4.1, U10.17 (OUT_B+)
/Audio/AMP_OUT_B-: C42.2, FB5.1, U10.20 (OUT_B-)
/Audio/PVDD: C36.1, C37.1, C38.1, C43.1, C44.1, C45.1, FB1.2, U10.15 (PVDD), U10.16 (PVDD), U10.27 (PVDD), U10.28 (PVDD)
/Audio/SPEAKER_A+: C46.1, C51.1, FB2.2, J14.2
/Audio/SPEAKER_A-: C47.1, C52.1, FB3.2, J14.1
/Audio/SPEAKER_B+: C48.1, C53.1, FB4.2, J15.1
/Audio/SPEAKER_B-: C49.1, C54.1, FB5.2, J15.2
/BAT_~ALERT: R51.2, TP9.1, U1.27 (IO47), U12.5 (~ALRT)
/CHG_STAT: R50.2, TP8.1, U1.30 (IO48), U8.1 (STAT)
/CODEC_~PDN: R61.2, U1.5 (IO1), U10.12 (~PDN)
/DISP_CS: J2.3, U1.9 (IO5)
/DISP_DC: J2.2, U1.10 (IO6)
/DISP_RST: J2.1, U1.11 (IO7)
/ENC_A: J5.4, R8.2, U1.20 (IO16)
/ENC_B: J5.3, R10.2, U1.21 (IO17)
/ENC_BTN: C64.1, J5.2, R13.2, U1.22 (IO18)
/HBI/PAW_A_B1: J6.1, R19.2, U2.10 (P0)
/HBI/PAW_A_B2: J6.5, R22.2, U2.11 (P1)
/HBI/PAW_A_B3: J6.9, R25.2, U2.12 (P2)
/HBI/PAW_A_B4: J6.13, R28.2, U2.14 (P3)
/HBI/PAW_A_B5: J6.17, R31.2, U2.16 (P4)
/HBI/PAW_A_B6: J6.21, R34.2, U2.17 (P5)
/HBI/PAW_A_D1: J6.3, U5.6 (~OUT0)
/HBI/PAW_A_D2: J6.7, U5.7 (~OUT1)
/HBI/PAW_A_D3: J6.11, U5.9 (~OUT2)
/HBI/PAW_A_D4: J6.15, U5.10 (~OUT3)
/HBI/PAW_A_D5: J6.19, U5.11 (~OUT4)
/HBI/PAW_A_D6: J6.23, U5.12 (~OUT5)
/HBI/PAW_B_B1: J7.1, R37.2, U2.19 (P6)
/HBI/PAW_B_B2: J7.5, R40.2, U2.20 (P7)
/HBI/PAW_B_B3: J7.9, R20.2, U3.10 (P0)
/HBI/PAW_B_B4: J7.13, R23.2, U3.11 (P1)
/HBI/PAW_B_B5: J7.17, R26.2, U3.12 (P2)
/HBI/PAW_B_B6: J7.21, R29.2, U3.14 (P3)
/HBI/PAW_B_D1: J7.3, U5.14 (~OUT6)
/HBI/PAW_B_D2: J7.7, U5.15 (~OUT7)
/HBI/PAW_B_D3: J7.11, U6.6 (~OUT0)
/HBI/PAW_B_D4: J7.15, U6.7 (~OUT1)
/HBI/PAW_B_D5: J7.19, U6.9 (~OUT2)
/HBI/PAW_B_D6: J7.23, U6.10 (~OUT3)
/HBI/PAW_C_B1: J8.1, R32.2, U3.16 (P4)
/HBI/PAW_C_B2: J8.5, R35.2, U3.17 (P5)
/HBI/PAW_C_B3: J8.9, R38.2, U3.19 (P6)
/HBI/PAW_C_B4: J8.13, R41.2, U3.20 (P7)
/HBI/PAW_C_B5: J8.17, R21.2, U4.10 (P0)
/HBI/PAW_C_B6: J8.21, R24.2, U4.11 (P1)
/HBI/PAW_C_D1: J8.3, U6.11 (~OUT4)
/HBI/PAW_C_D2: J8.7, U6.12 (~OUT5)
/HBI/PAW_C_D3: J8.11, U6.14 (~OUT6)
/HBI/PAW_C_D4: J8.15, U6.15 (~OUT7)
/HBI/PAW_C_D5: J8.19, U7.6 (~OUT0)
/HBI/PAW_C_D6: J8.23, U7.7 (~OUT1)
/HBI/PAW_D_B1: J9.1, R27.2, U4.12 (P2)
/HBI/PAW_D_B2: J9.5, R30.2, U4.14 (P3)
/HBI/PAW_D_B3: J9.9, R33.2, U4.16 (P4)
/HBI/PAW_D_B4: J9.13, R36.2, U4.17 (P5)
/HBI/PAW_D_B5: J9.17, R39.2, U4.19 (P6)
/HBI/PAW_D_B6: J9.21, R42.2, U4.20 (P7)
/HBI/PAW_D_D1: J9.3, U7.9 (~OUT2)
/HBI/PAW_D_D2: J9.7, U7.10 (~OUT3)
/HBI/PAW_D_D3: J9.11, U7.11 (~OUT4)
/HBI/PAW_D_D4: J9.15, U7.12 (~OUT5)
/HBI/PAW_D_D5: J9.19, U7.14 (~OUT6)
/HBI/PAW_D_D6: J9.23, U7.15 (~OUT7)
/HBI_INT: R17.2, U1.19 (IO15), U2.1 (~INT), U3.1 (~INT), U4.1 (~INT)
/HBI_RST: R18.2, U1.18 (IO14), U5.17 (~RESET), U6.17 (~RESET), U7.17 (~RESET)
/I2C1_SCL: J1.2, R1.2, U1.15 (IO11), U2.2 (SCL), U3.2 (SCL), U4.2 (SCL), U5.18 (SCL), U6.18 (SCL), U7.18 (SCL), U10.11 (SCL), U12.7 (SCL)
/I2C1_SDA: J1.3, R2.2, U1.14 (IO10), U2.4 (SDA), U3.4 (SDA), U4.4 (SDA), U5.19 (SDA), U6.19 (SDA), U7.19 (SDA), U10.10 (SDA), U12.8 (SDA)
/I2S1_BCLK: U1.6 (IO2), U10.7 (SCLK)
/I2S1_DOUT: U1.8 (IO4), U10.8 (SDIN)
/I2S1_WS: U1.7 (IO3), U10.6 (LRCLK)
/JTAG_TCK: J13.4, U1.35 (IO39)
/JTAG_TDI: J13.8, U1.37 (IO41)
/JTAG_TDO: J13.6, U1.36 (IO40)
/JTAG_TMS: J13.2, U1.38 (IO42)
/MCU_IO0: J11.6, J17.2, JP4.1 (A), R16.2, SW2.2, U1.4 (IO0)
/MCU_RXD: J11.5, JP1.1 (A), U1.40 (RXD0)
/MCU_TXD: J11.3, JP2.1 (A), U1.39 (TXD0)
/MCU_~RST: C5.1, J11.1, J13.10, J17.3, JP3.1 (A), R15.2, SW1.2, U1.45 (EN)
/Power/3V3_L1: L1.1, U9.4 (L1)
/Power/3V3_L2: L1.2, U9.2 (L2)
/Power/12V_SW: C21.1, L2.2, U13.4 (SW), U13.9 (SW)
/Power/SWITCHER_VIN: C13.1, C25.1, C26.1, C62.1, D3.1 (K), L2.1, Q1.2 (S), R47.1, U9.5 (VIN), U13.7 (VIN)
/SD_CLK: J3.5 (CLK), R9.2, U1.32 (IO36)
/SD_CMD: J3.3 (CMD), R7.2, U1.31 (IO35)
/SD_D0: J3.7 (DAT0), R11.2, U1.33 (IO37)
/SD_D1: J3.8 (DAT1), R12.2, U1.34 (IO38)
/SD_D2: J3.1 (DAT2), R3.2, U1.28 (IO33)
/SD_D3: J3.2 (DAT3/CD), R4.2, U1.29 (IO34)
/SD_DET: J3.10 (DET_A), R14.2, U1.26 (IO26)
/SPI2_CLK: J2.4, U1.13 (IO9)
/SPI2_MOSI: J2.5, U1.12 (IO8)
/USB1_D+: D2.2 (A2), J4.A6 (D+), J4.B6 (D+), U1.24 (IO20)
/USB1_D-: D1.2 (A2), J4.A7 (D-), J4.B7 (D-), U1.23 (IO19)
/USB_UART/USB2_D+: D7.2 (A2), J16.A6 (D+), J16.B6 (D+), U11.7 (UD+)
/USB_UART/USB2_D-: D5.2 (A2), J16.A7 (D-), J16.B7 (D-), U11.8 (UD-)
/USB_UART/USB2_VBUS: C57.1, C63.1, D6.2 (A2), J16.A4 (VBUS), J16.A9 (VBUS), J16.B4 (VBUS), J16.B9 (VBUS), U11.3 (VDD5), U11.9 (VBUS)
/USB_UART/USB_UART_MCU_GPIO0_CHIP: JP4.2 (B), Q6.3 (C)
/USB_UART/USB_UART_MCU_~RST_CHIP: JP3.2 (B), Q5.3 (C)
/USB_UART/USB_UART_RXD_CHIP: JP2.2 (B), U11.5 (RXD)
/USB_UART/USB_UART_TXD_CHIP: JP1.2 (B), U11.4 (TXD)
GND: C1.2, C2.2, C3.2, C4.2, C5.2, C6.2, C7.2, C8.2, C9.2, C10.2, C11.2, C12.2, C13.2, C14.2, C15.2, C16.2, C17.2, C18.2, C19.2, C20.2, C22.2, C23.2, C24.2, C25.2, C33.2, C34.1, C35.1, C36.2, C37.2, C38.2, C43.2, C44.2, C45.2, C46.2, C47.2, C48.2, C49.2, C50.2, C55.2, C56.2, C57.2, C58.2, C59.2, C61.2, C62.2, C63.2, C64.2, C65.2, D1.1 (A1), D2.1 (A1), D4.1 (K), D5.1 (A1), D6.1 (A1), D7.1 (A1), D8.1 (A1), H1.1, H2.1, H3.1, J1.1, J2.6, J3.6 (VSS), J3.9 (DET_B), J3.11 (SHIELD), J4.A1 (GND), J4.A12 (GND), J4.B1 (GND), J4.B12 (GND), J4.S1 (SHIELD), J5.1, J6.2, J6.6, J6.10, J6.14, J6.18, J6.22, J7.2, J7.6, J7.10, J7.14, J7.18, J7.22, J8.2, J8.6, J8.10, J8.14, J8.18, J8.22, J9.2, J9.6, J9.10, J9.14, J9.18, J9.22, J10.1, J11.4, J12.1, J13.3, J13.5, J13.7, J13.9, J16.A1 (GND), J16.A12 (GND), J16.B1 (GND), J16.B12 (GND), J16.S1 (SHIELD), J17.1, NT1.1, NT2.1, NT3.1, NT4.1, NT5.1, NT6.1, NT7.1, NT8.1, NT9.1, NT10.1, NT11.1, NT12.1, NT13.1, NT14.1, R5.2, R6.2, R43.2, R44.2, R45.2, R46.2, R48.2, R49.2, R52.2, R54.2, R55.2, R61.1, R63.2, R64.2, R65.2, R66.2, R67.2, R68.2, SW1.1, SW2.1, U1.1 (GND), U1.2 (GND), U1.42 (GND), U1.43 (GND), U1.46 (GND), U1.47 (GND), U1.48 (GND), U1.49 (GND), U1.50 (GND), U1.51 (GND), U1.52 (GND), U1.53 (GND), U1.54 (GND), U1.55 (GND), U1.56 (GND), U1.57 (GND), U1.58 (GND), U1.59 (GND), U1.60 (GND), U1.61 (GND), U1.61_1 (GND), U1.61_2 (GND), U1.61_3 (GND), U1.61_4 (GND), U1.61_5 (GND), U1.61_6 (GND), U1.61_7 (GND), U1.61_8 (GND), U1.62 (GND), U1.63 (GND), U1.64 (GND), U1.65 (GND), U2.6 (A0), U2.7 (A1), U2.9 (A2), U2.15 (VSS), U3.7 (A1), U3.9 (A2), U3.15 (VSS), U4.6 (A0), U4.9 (A2), U4.15 (VSS), U5.2 (A0), U5.3 (A1), U5.4 (A2), U5.5 (A3), U5.8 (GND), U5.13 (GND), U5.16 (GND), U6.3 (A1), U6.4 (A2), U6.5 (A3), U6.8 (GND), U6.13 (GND), U6.16 (GND), U7.2 (A0), U7.4 (A2), U7.5 (A3), U7.8 (GND), U7.13 (GND), U7.16 (GND), U8.2 (VSS), U9.3 (PGND), U9.9 (GND), U9.11 (PGND), U10.1 (DGND), U10.5 (DGND), U10.14 (AGND), U10.19 (PGND), U10.24 (PGND), U10.29 (PAD), U11.2 (GND), U11.17 (GND), U12.1 (CTG), U12.4 (GND), U12.6 (QSTRT), U12.9 (PAD), U13.10 (AGND)
GNDPWR: C26.2, C27.2, C28.2, C29.2, C30.2, C31.2, C32.2, NT1.2, NT2.2, NT3.2, NT4.2, NT5.2, NT6.2, NT7.2, NT8.2, NT9.2, NT10.2, NT11.2, NT12.2, NT13.2, NT14.2, U13.3 (PGND)
unnamed: C51.2, R63.1
unnamed: C52.2, R64.1
unnamed: C53.2, R65.1
unnamed: C54.2, R66.1
unnamed: C60.2, R55.1
unnamed: D4.2 (A), R56.2
unnamed: J4.A5 (CC1), R5.1
unnamed: J4.B5 (CC2), R6.1
unnamed: J16.A5 (CC1), R67.1
unnamed: J16.B5 (CC2), R68.1
unnamed: Q5.1 (B), R69.2
unnamed: Q5.2 (E), R70.1, U11.13 (RTS)
unnamed: Q6.1 (B), R70.2
unnamed: Q6.2 (E), R69.1, U11.12 (DTR)
unnamed: R56.1, U1.17 (IO13)
unnamed: R43.1, U5.1 (REXT)
unnamed: R44.1, U6.1 (REXT)
unnamed: R45.1, U7.1 (REXT)
unnamed: R49.1, U8.5 (PROG)
unnamed: C12.1, R47.2, U9.6 (EN), U9.8 (VINA)
unnamed: R62.2, U10.3 (ADR/~FAULT)
unnamed: C35.2, U10.13 (AVDD)
unnamed: C39.1, U10.25 (BST_A+)
unnamed: C40.1, U10.22 (BST_A-)
unnamed: C41.1, U10.18 (BST_B+)
unnamed: C42.1, U10.21 (BST_B-)
unnamed: C34.2, U10.4 (VR_DIG)
unnamed: C58.1, U11.6 (V3)
unnamed: C21.2, U13.8 (BST)
unnamed: C60.1, C61.1, U13.2 (COMP)
unnamed: C59.1, R53.2, R54.1, U13.1 (FB)
unnamed: C20.1, U13.11 (VCC)
VBUS: C18.1, D3.2 (A), D8.2 (A2), J4.A4 (VBUS), J4.A9 (VBUS), J4.B4 (VBUS), J4.B9 (VBUS), Q1.1 (G), R48.1, U8.4 (VDD)
VCC: C1.1, C2.1, C3.1, C4.1, C6.1, C7.1, C8.1, C9.1, C10.1, C11.1, C14.1, C15.1, C16.1, C50.1, C55.1, C56.1, J1.4, J2.7, J3.4 (VDD), J11.2, J13.1, R1.1, R2.1, R3.1, R4.1, R7.1, R8.1, R9.1, R10.1, R11.1, R12.1, R13.1, R14.1, R15.1, R16.1, R17.1, R18.1, R19.1, R20.1, R21.1, R22.1, R23.1, R24.1, R25.1, R26.1, R27.1, R28.1, R29.1, R30.1, R31.1, R32.1, R33.1, R34.1, R35.1, R36.1, R37.1, R38.1, R39.1, R40.1, R41.1, R42.1, R50.1, R51.1, R62.1, TP4.1, U1.3 (3V3), U2.5 (VDD), U3.5 (VDD), U3.6 (A0), U4.5 (VDD), U4.7 (A1), U5.20 (VCC), U6.2 (A0), U6.20 (VCC), U7.3 (A1), U7.20 (VCC), U9.1 (VOUT), U9.10 (FB), U10.2 (DVDD), U11.1 (VIO)
