drachosaurus/hoerbaer/Firmware/HoerBaerFirmware/src/devices/TLC59108.h

/*
 * TLC59108: Arduino library to control TI TLC59108/TLC59108F/TLC59208 LED drivers
 * 
 * (C) 2013 Christopher Smith <chrylis@gmail.com>
 * 
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
 * You should have received a copy of the GNU Lesser General Public License
 * along with this program.  If not, see <http://www.gnu.org/licenses/>.
 */

#ifndef TLC59108_H
#define TLC59108_H

#include <Arduino.h>
#include <memory>
#include "Wire.h"

class TLC59108
{
public:
	static const uint8_t NUM_CHANNELS = 8;

	// default I2C addresses
	// datasheet, pp 12-13
	struct I2C_ADDR
	{
		static const uint8_t BASE = 0x40;
		static const uint8_t SWRESET = 0x4b;
		static const uint8_t ALLCALL = 0x48;
		static const uint8_t SUB1 = 0x49;
		static const uint8_t SUB2 = 0x4a;
		static const uint8_t SUB3 = 0x4c;
	};

	// register auto-increment modes for setting multiple registers
	// datasheet, p 13
	struct AUTO_INCREMENT
	{
		static const uint8_t ALL = 0x80; // increment through all registers (for initial setup)
		static const uint8_t IND = 0xa0; // increment through individual brightness registers
		static const uint8_t GLOBAL = 0xc0; // increment through global control registers
		static const uint8_t INDGLOBAL = 0xe0; // increment through individual and global registers
	};

	struct LED_MODE
	{
		static const uint8_t OFF = 0;
		static const uint8_t FULL_ON = 1;
		static const uint8_t PWM_IND = 2;
		static const uint8_t PWM_INDGRP = 3;
	};

	// register names
	// datasheet, p 16
	struct REGISTER
	{
	public:
		struct MODE1
		{
			static const uint8_t ADDR = 0x00;

			static const uint8_t OSC_OFF = 0x10;
			static const uint8_t SUB1 = 0x08;
			static const uint8_t SUB2 = 0x04;
			static const uint8_t SUB3 = 0x02;
			static const uint8_t ALLCALL = 0x01;
		};

		struct MODE2
		{
			static const uint8_t ADDR = 0x01;

			static const uint8_t EFCLR = 0x80;
			static const uint8_t DMBLNK = 0x20;
			static const uint8_t OCH = 0x08;
		};

		struct PWM0
		{
			static const uint8_t ADDR = 0x02;
		};

		struct PWM1
		{
			static const uint8_t ADDR = 0x03;
		};

		struct PWM2
		{
			static const uint8_t ADDR = 0x04;
		};

		struct PWM3
		{
			static const uint8_t ADDR = 0x05;
		};

		struct PWM4
		{
			static const uint8_t ADDR = 0x06;
		};

		struct PWM5
		{
			static const uint8_t ADDR = 0x07;
		};

		struct PWM6
		{
			static const uint8_t ADDR = 0x08;
		};

		struct PWM7
		{
			static const uint8_t ADDR = 0x09;
		};

		struct GRPPWM
		{
			static const uint8_t ADDR = 0x0a;
		};

		struct GRPFREQ
		{
			static const uint8_t ADDR = 0x0b;
		};

		struct LEDOUT0
		{
			static const uint8_t ADDR = 0x0c;
		};

		struct LEDOUT1
		{
			static const uint8_t ADDR = 0x0d;
		};

		struct SUBADR1
		{
			static const uint8_t ADDR = 0x0e;
		};

		struct SUBADR2
		{
			static const uint8_t ADDR = 0x0f;
		};

		struct SUBADR3
		{
			static const uint8_t ADDR = 0x10;
		};

		struct ALLCALLADR
		{
			static const uint8_t ADDR = 0x11;
		};

		struct IREF
		{
			static const uint8_t ADDR = 0x12;

			static const uint8_t CM = 0x80; // current multiplier
			static const uint8_t HC = 0x40; // subcurrent
		};

		struct EFLAG
		{
			static const uint8_t ADDR = 0x13;
		};
	};

	struct ERROR
	{
		static const uint8_t EINVALID = 2;
	};

public:

	// creates an instance managing drivers on the specified interface and address
	TLC59108(std::shared_ptr<TwoWire> i2c, const uint8_t i2c_address);

	// initializes the driver by performing a hardware reset (if pin is specified) and enabling the oscillator
	uint8_t init(const uint8_t hwResetPin = 0);

	// writes a value into a single register
	uint8_t setRegister(const uint8_t reg, const uint8_t value);

	// writes values into multiple registers
	uint8_t setRegisters(const uint8_t startReg, const uint8_t values[], const uint8_t numValues);

	// reads a single register; returns -1 on error
	int readRegister(const uint8_t reg) const;

	// reads multiple registers into the specified array
	// returns the number of uint8_ts successfully read
	uint8_t readRegisters(uint8_t *dest, const uint8_t startReg, const uint8_t num) const;

	uint8_t setBrightness(const uint8_t pwmChannel, const uint8_t dutyCycle);

	uint8_t setAllBrightness(const uint8_t dutyCycle);

	// requires an array of size 8
	uint8_t setAllBrightness(const uint8_t dutyCycles[]);

	// requires an array of size 8
	bool getAllBrightness(uint8_t dutyCycles[]) const;

	// sets all channels to the output modes listed in REGISTER::LED_MODE
	uint8_t setLedOutputMode(const uint8_t outputMode);

private:
	std::shared_ptr<TwoWire> i2c;
	uint8_t addr;
};

#endif // TLC59108_H
