drachosaurus/hoerbaer/Firmware/HoerBaerFirmware/src/hbi.h

#pragma once

#include <memory>
#include <FreeRTOS.h>
#include <Wire.h>
#include "devices/TLC59108.h"
#include "devices/PCF8574.h"
#include "userconfig.h"
#include "audioplayer.h"

class HBI;

class HBI {
    private:
        shared_ptr<TwoWire> i2c;
        shared_ptr<HBIConfig> hbiConfig;
        uint32_t lastKnownButtonMask;
        uint8_t slotIos[24];
        uint8_t ioSlots[24];
        uint8_t slotCount;
        uint32_t playButtonsIoMask;
        uint32_t pauseButtonsIoMask;
        uint32_t powerLedsIoMask;
        uint32_t currentLedState;
        int currentVegasStep;
        SemaphoreHandle_t i2cSema;
        unique_ptr<TLC59108> ledDriver1;
        unique_ptr<TLC59108> ledDriver2;
        unique_ptr<TLC59108> ledDriver3;
        unique_ptr<PCF8574> ioExpander1;
        unique_ptr<PCF8574> ioExpander2;
        unique_ptr<PCF8574> ioExpander3;
        shared_ptr<AudioPlayer> audioPlayer;
        void (*shutdownCallback)(void);
        uint32_t getButtonsState();
        void checkLongPressState();
        void setLedState();
        void dispatchButtonInput(uint32_t buttonMask);
        void dispatchEncoderButton(bool longPress);
        bool actionButtonsEnabled = false;
        bool readyToPlay = false;
    public:
        HBI(shared_ptr<TwoWire> i2c, SemaphoreHandle_t i2cSema, shared_ptr<HBIConfig> hbiConfig, shared_ptr<AudioPlayer> audioPlayer, void (*shutdownCallback)(void));
        void initialize();
        void setReadyToPlay(bool ready);
        void runWorkerTask();
        void lightUpAllLeds();
        void shutOffAllLeds();
        void waitUntilEncoderButtonReleased();
        bool getAnyButtonPressed();
        void runVegasStep();
        void setActionButtonsEnabled(bool enabled);
};
