drachosaurus/hoerbaer/(commit log)

2023-11-12 Nearly complete schematic with TLV61048 as 12V booster.
    [Hoerbaer.kicad_sch, audio.kicad_sch, hbi.kicad_sch, power.kicad_sch, usb_uart.kicad_sch]
2023-11-12 Footprints, order numbers, ...
    [Hoerbaer.kicad_pcb, Hoerbaer.kicad_sch, TPS61288 Calculation tool.xlsx, audio.kicad_sch, hbi.kicad_sch, power.kicad_sch, usb_uart.kicad_sch]
2023-11-12 More numbers, changed HBI input package, i2c addresses, layout.
    [Hoerbaer.kicad_pcb, Hoerbaer.kicad_sch, audio.kicad_sch, hbi.kicad_sch, power.kicad_sch, usb_uart.kicad_sch]
2023-11-12 Schematic, first idea
    [Hoerbaer.kicad_pcb, Hoerbaer.kicad_sch, audio.kicad_sch, hbi.kicad_sch, power.kicad_sch, usb_uart.kicad_sch]
2023-11-12 Layout drc error free
    [Hoerbaer.kicad_pcb, Hoerbaer.kicad_sch, TPS61288 Calculation tool.xlsx, audio.kicad_sch, hbi.kicad_sch, power.kicad_sch, usb_uart.kicad_sch]
2023-11-12 Adjos refdes silkscreen
    [Hoerbaer.kicad_pcb]
2023-11-12 Drachosaurus added
    [Hoerbaer.kicad_pcb, audio.kicad_sch]
2023-11-12 Order numbers
    [Hoerbaer.kicad_pcb, Hoerbaer.kicad_sch, audio.kicad_sch, hbi.kicad_sch, power.kicad_sch, usb_uart.kicad_sch]
2023-11-12 Renamed JLCPCB attribute to LCSC (plugin search list)
    [Hoerbaer.kicad_pcb, Hoerbaer.kicad_sch, audio.kicad_sch, hbi.kicad_sch, power.kicad_sch, usb_uart.kicad_sch]
2023-11-12 Resistor Order Numbers
    [Hoerbaer.kicad_sch, audio.kicad_sch, hbi.kicad_sch, power.kicad_sch, usb_uart.kicad_sch]
2023-11-12 Fixed net tie ground plane issue.
    [Hoerbaer.kicad_pcb, Hoerbaer.kicad_sch, audio.kicad_sch, hbi.kicad_sch, power.kicad_sch, usb_uart.kicad_sch]
2023-11-12 Many small corrections, changed connectors, ...
    [Hoerbaer.kicad_pcb, Hoerbaer.kicad_sch, audio.kicad_sch, hbi.kicad_sch, power.kicad_sch]
2023-11-12 Added an additional connector. And silk screen designs.
    [Hoerbaer.kicad_pcb, Hoerbaer.kicad_sch, usb_uart.kicad_sch]
2023-11-12 DRC fixes
    [power.kicad_sch]
2023-11-12 Vias around the edge, more gnd vias under the ESP module.
2023-11-12 Production Files for Revision 1
    [bom.csv, designators.csv, positions.csv]
2023-11-13 Fixed 1uF order number.
    [Hoerbaer.kicad_sch, audio.kicad_sch, power.kicad_sch, usb_uart.kicad_sch]
2023-12-06 Added sd card reverse adapter pcb
    [Hoerbaer.kicad_sch, uSDAdapter.kicad_pcb, uSDAdapter.kicad_sch]
2023-12-06 Wire up some firmware structure.
2023-12-06 Fork TLC59108 lib (shared "Wire"), added initial LEDs code
2023-12-06 Fixed I2C addresses
    [Hoerbaer.kicad_sch]
2023-12-06 Setup input expanders
    [Hoerbaer.kicad_sch]
2023-12-06 lock semaphore when using i2c.
2023-12-07 Simple prototype case
    [Proto Case Encoder Holder.stl, Proto Case Top.stl]
2023-12-07 Added 3d model for USB footprint.
    [Hoerbaer.kicad_sch, usb_uart.kicad_sch]
2023-12-10 Audio Progress... codec registers vs. I2S configuration.
    [Hoerbaer.kicad_sch]
2023-12-17 Refactored HBI to private -> member workaround
    [audioplayer.cpp, audioplayer.h, config.h, hbi.cpp, hbi.h, main.cpp, userconfig.cpp, userconfig.h]
2023-12-17 WIP: slot configuration progress.
2025-02-27 Kicad 9 - additional notes
2025-03-14 USB msc v1 working
    [Hoerbaer.kicad_pcb]
2025-03-14 USB mode when any button is pressed
2025-03-16 More notes
    [Hoerbaer.kicad_pcb]
2025-03-23 Utility methods, some fixes
    [TAS5806.cpp, hbi.cpp, hbi.h, main.cpp]
2025-03-24 WIP new hw rev
    [Hoerbaer.kicad_sch, TPS61288 Calculation tool.xlsx, audio.kicad_sch, hbi.kicad_sch, power.kicad_sch, usb_uart.kicad_sch]
2025-03-24 Layout, mono-jumpers
    [Hoerbaer.kicad_sch, audio.kicad_sch, hbi.kicad_sch, power.kicad_sch]
2025-03-29 Layout rev 2 - without silkscreen
    [Hoerbaer.kicad_sch, audio.kicad_sch, hbi.kicad_sch, power.kicad_sch]
2025-03-29 Silkscreen, warnings, ...
2025-03-30 Added more jumper options.
    [HoerbaerV2Tatze.kicad_pcb, HoerbaerV2Tatze.kicad_sch, HoerbaerV2Tatze.sch, Pfote.dxf, audio.kicad_sch, hbi.kicad_sch, power.kicad_sch]
2025-03-30 Check inductance for 9v - ok
    [TPS61288 Calculation tool.xlsx, power.kicad_sch]
2025-03-30 Tatze - positions
    [HoerbaerV2Tatze.kicad_pcb, HoerbaerV2Tatze.kicad_sch]
2025-03-30 Tatze grösser
    [HoerbaerV2Tatze.kicad_pcb]
2025-03-30 Löcher
    [HoerbaerV2Tatze.kicad_pcb, HoerbaerV2Tatze.kicad_sch]
2025-03-30 BOM FIxes
    [Hoerbaer.kicad_sch, audio.kicad_sch, hbi.kicad_sch, power.kicad_sch, usb_uart.kicad_sch]
2025-04-01 Layout fixes (production feedback)
    [Hoerbaer.kicad_sch, audio.kicad_sch, hbi.kicad_sch, power.kicad_sch]
2025-04-11 Layout fixes, production fixes
    [Abdeckung Anschlüsse.stl, audio.kicad_sch, hbi.kicad_sch, power.kicad_sch]
2025-04-11 Firmware prep for new pcb
2025-04-12 PSRAM fixes, latest arduino lib (PSRAM / Audio issue)
    [main.cpp]
2025-04-18 Firmware progress - sd card fixes, mono mode, ...
    [TAS5806.cpp, TAS5806.h, audioplayer.cpp, audioplayer.h, config.h, hbi.cpp, hbi.h, main.cpp]
2025-04-20 HBI mapping fixes
    [Abdeckung Anschlüsse.stl, Button Führung gross.stl, Button Führung klein.stl, Button Führung.3mf, Halterung PCB.3mf, Halterung PCB.stl]
2025-04-20 Read ID3 tags
    [Abdeckung Anschlüsse.3mf]
2025-04-26 Added more memory tracing
    [Button Führung.3mf]
2025-04-27 Removed not working consts
    [bleremote.cpp]
2025-05-10 LED brightness, playing info, ...
    [audio.kicad_sch, hbi.kicad_sch, power.kicad_sch]
2025-05-25 Fixed next / prev with many files -> use count and total from file cache
    [audioplayer.cpp, sdcard.cpp]
2025-10-25 Wire up RFID class
2025-10-25 RFID I2C implementation - runtime issue
    [hbi.h, main.cpp, rfid.cpp, rfid.h]
